antroseco/idp/Mechanical_DocumentationV2.pdf

# IDP - Mechanical documentation

## Team L212: The Seven Deadly Trins

## Trinity College

## Antros Economides 137 Jay Limachya 136 Jeevan Singh Bhoot 136 Valentina Njaradi 135 Nikodem Czarlinski 135 Omar Zaman 134 Jerry Shi 134

## 21 March 2021

# 1 Material Choice

## - 6mm thick MDF wood

## - PLA

## - 0.7mm thick sheet metal

# 2 Material Justification

## - Main goal was to create a simple and easy to manufacture robot

## - Wood used for the main body of the robot since it is easy to laser cut and put

## together

## - Comb joints are used here to increase the strength of the robot and are put together

## with wood glue. 6mm thick wood used to further increase the structural stability of the robot as it is the thickest material available

## - Sheet metal used for the brackets as it is easier to work with the bends

## - Use of PLA and 3D printing for parts which cannot be manufactured as easily with

## either wood or sheet metal

# 3 Manufacturing

## - Robot is laser cut via the dxf files (end of handout) on 6mm thick MDF wood and

## 0.7mm sheet metal

## - Wood glue used for the main body of the robot

## - Additional holes which need to be drilled are marked on the drawings

## - Sensors and other components are bolted to the robot in the positions shown in the drawings / renders

## - Holes in the 3D printed drawing are threaded

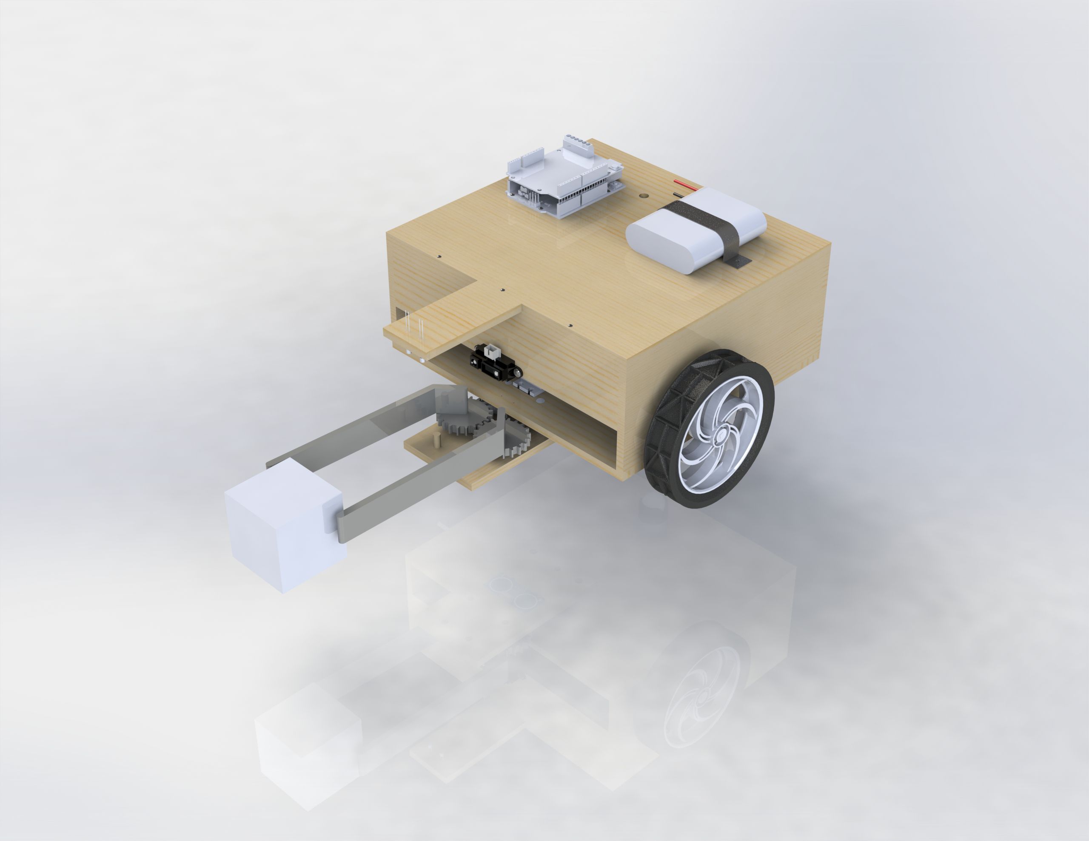
[picture p1: page 3]

5

4

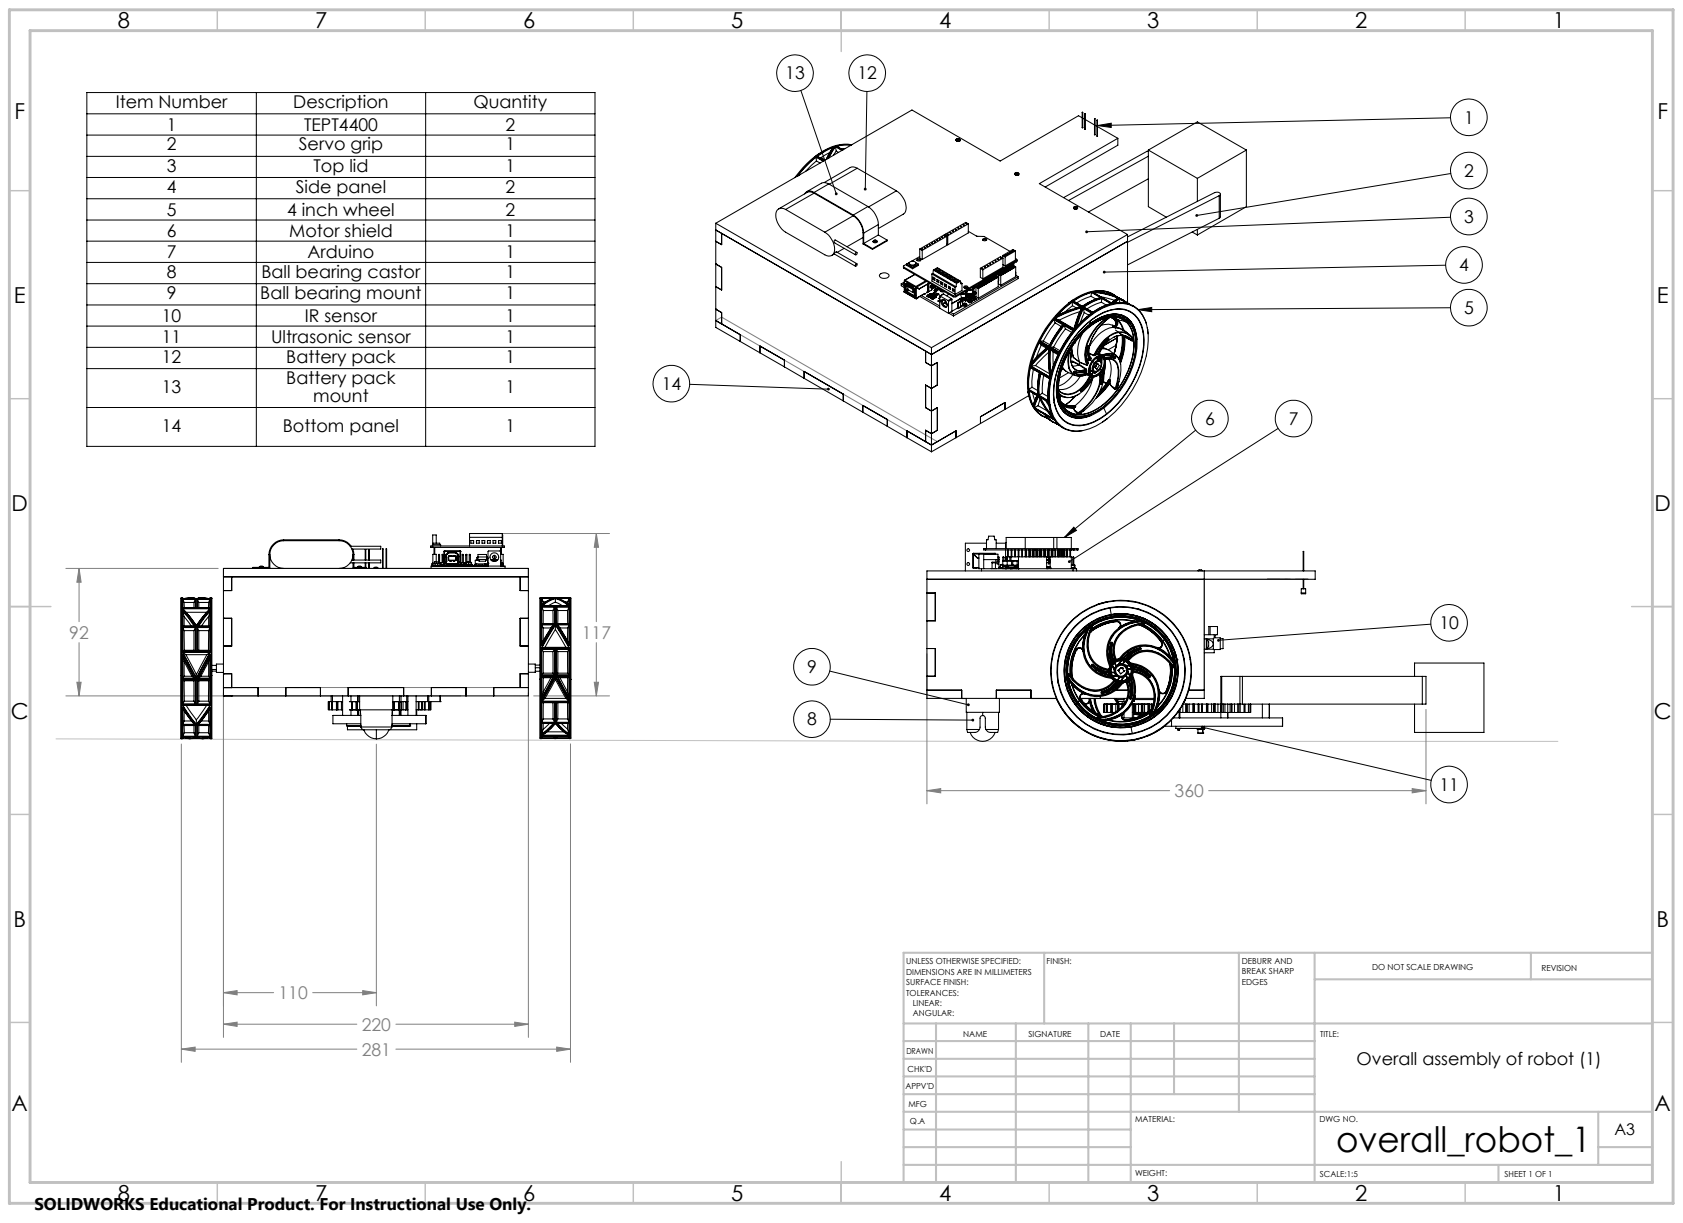
[picture p2: page 4]
FINISH:; DEBURR AND; BREAK SHARP EDGES; DO NOT SCALE DRAWING; REVISION; SCALE:1:5; SHEET 1 OF 1; WEIGHT:

Item Number | Description | Quantity
1 | TEPT4400 | 2
2 | Servo grip | 1
3 | Top lid | 1
4 | Side panel | 2
5 | 4 inch wheel | 2
6 | Motor shield | 1
7 | Arduino | 1
8 | Ball bearing castor | 1
9 | Ball bearing mount | 1
10 | IR sensor | 1
11 | Ultrasonic sensor | 1
12 | Battery pack | 1
13 | Battery pack mount | 1

14 | Bottom panel | 1

UNLESS OTHERWISE SPECIFIED:
DIMENSIONS ARE IN MILLIMETERS
SURFACE FINISH:
TOLERANCES:
LINEAR:
ANGULAR:

NAME | SIGNATURE | DATE | | | | TITLE: Overall assembly of robot (1)

DRAWN
CHK'D
APPV'D
MFG
Q.A | | | | MATERIAL: | DWG NO. overall_robot_1 | A3

SOLIDWORKS Educational Product. For Instructional Use Only.

E | E
F | F

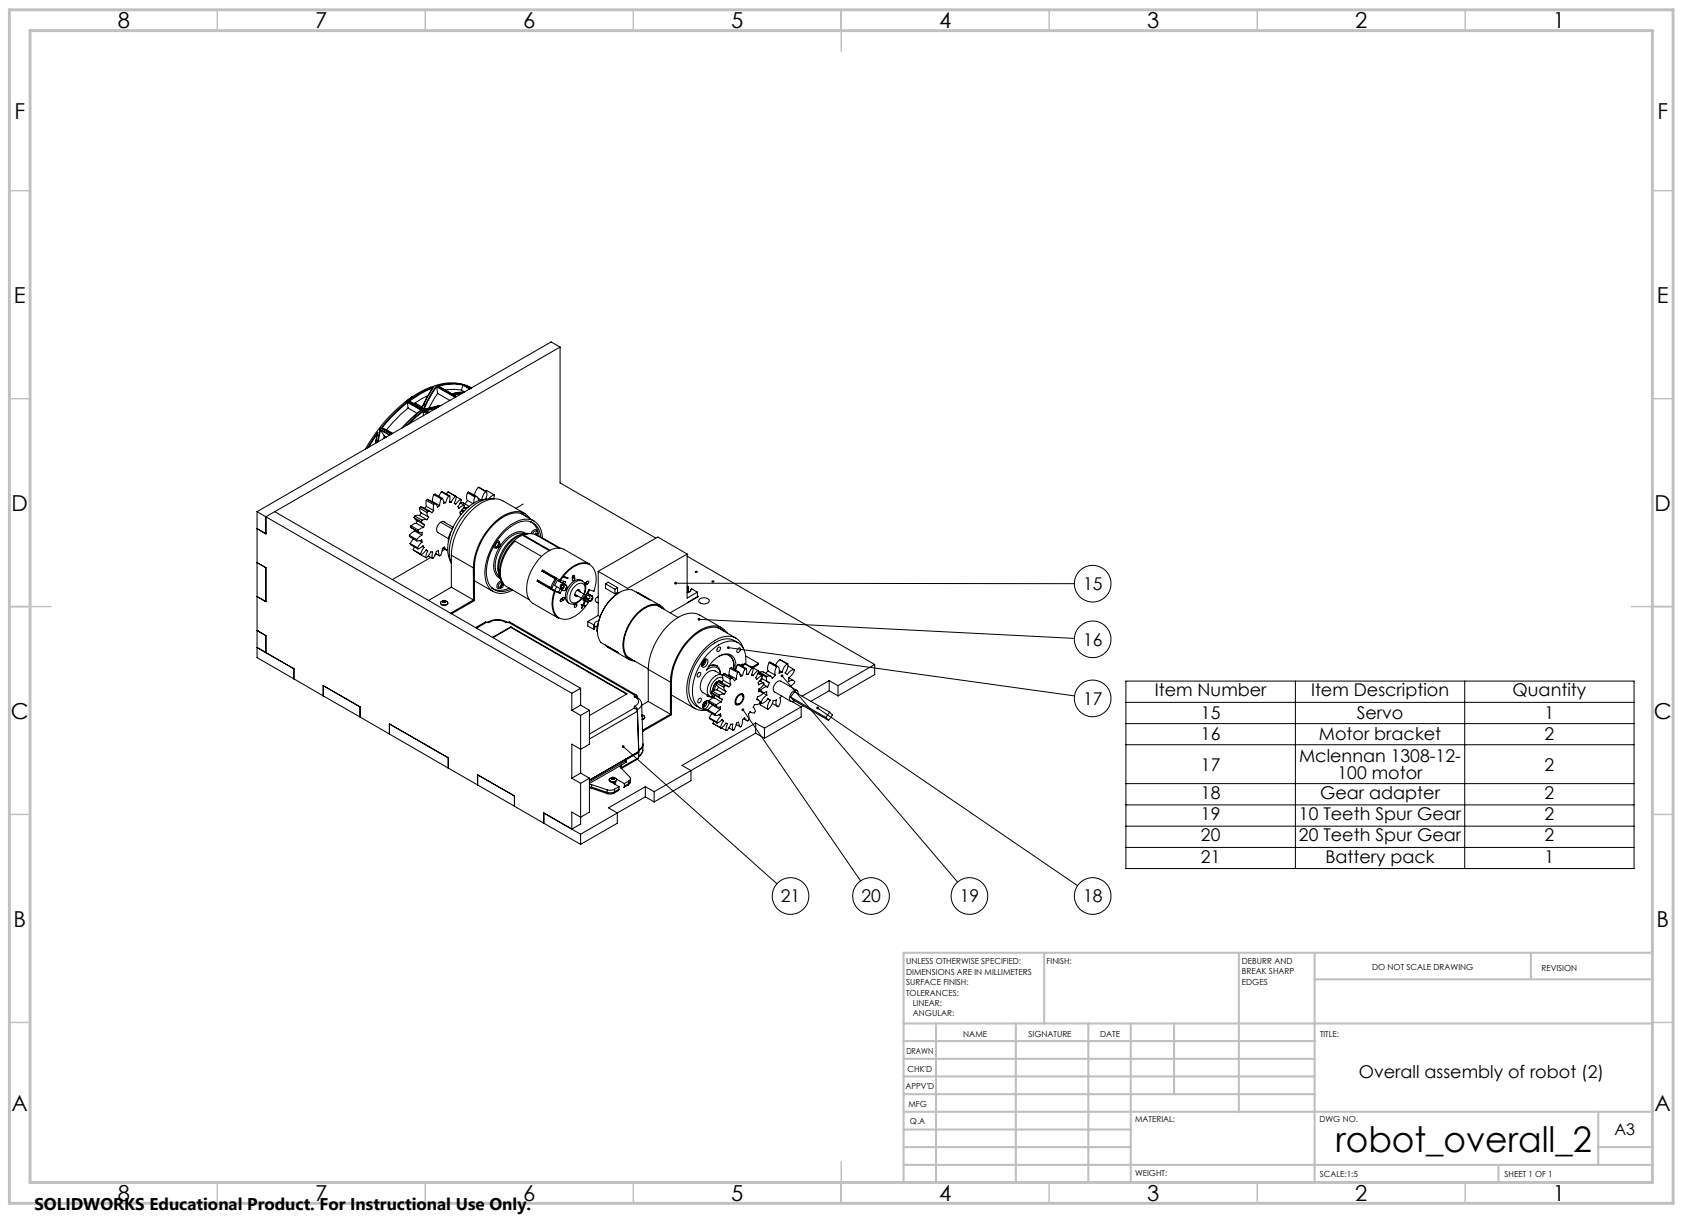
[picture p3: page 5]
FINISH:; DEBURR AND; BREAK SHARP EDGES; DO NOT SCALE DRAWING; REVISION

Item Number | Item Description | Quantity
15 | Servo | 1
16 | Motor bracket | 2
17 | Mclennan 1308-12-100 motor | 2
18 | Gear adapter | 2
19 | 10 Teeth Spur Gear | 2
20 | 20 Teeth Spur Gear | 2
21 | Battery pack | 1

UNLESS OTHERWISE SPECIFIED:
DIMENSIONS ARE IN MILLIMETERS
SURFACE FINISH:
TOLERANCES:
LINEAR:
ANGULAR:

NAME | SIGNATURE | DATE | | | TITLE: Overall assembly of robot (2)

DRAWN
CHK'D
APPV'D
MFG

robot_overall_2

SCALE:1:5 | SHEET 1 OF 1

E | E
F | F

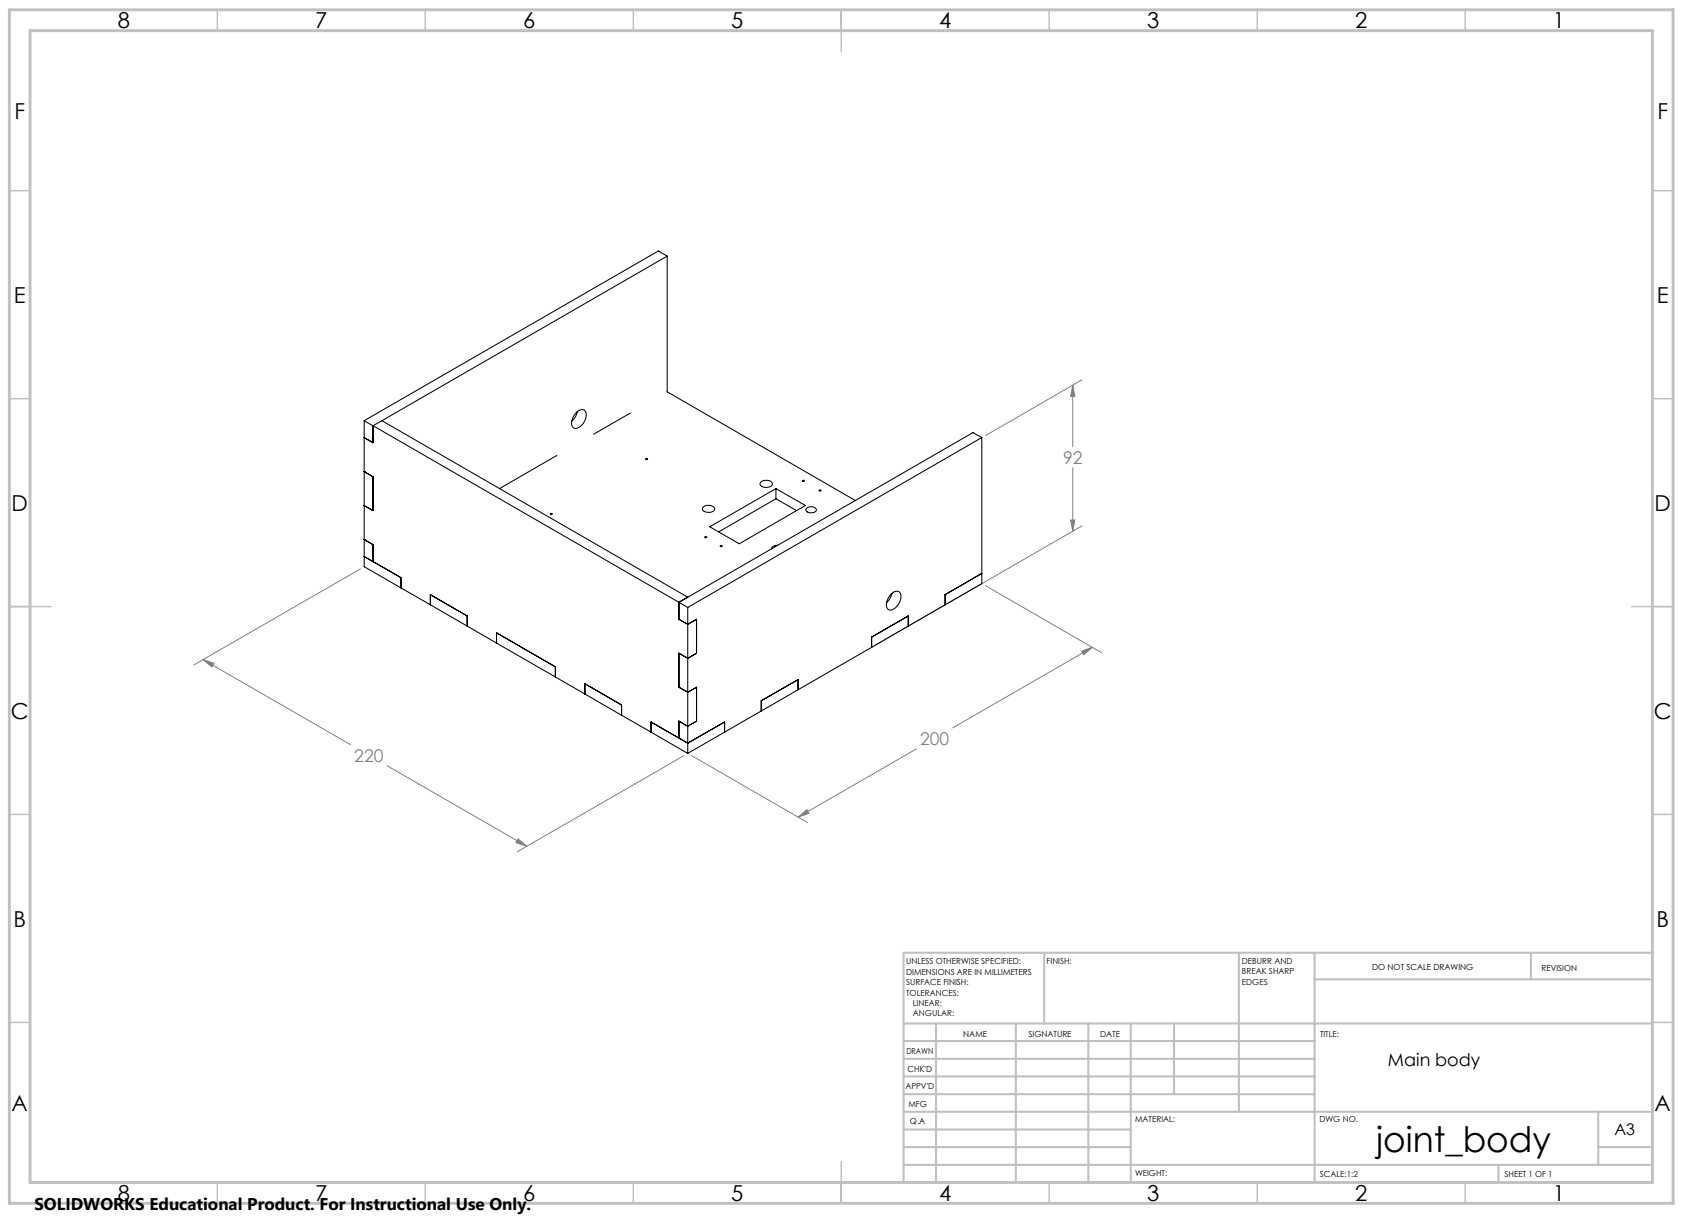
[picture p4: page 6]
FINISH:; DEBURR AND; BREAK SHARP EDGES; DO NOT SCALE DRAWING; REVISION

UNLESS OTHERWISE SPECIFIED:
DIMENSIONS ARE IN MILLIMETERS
SURFACE FINISH:
TOLERANCES:
LINEAR:
ANGULAR:

NAME | SIGNATURE | DATE | | | TITLE: Main body

DRAWN
CHK'D
APPV'D
MFG

joint_body

SCALE:1:2 | SHEET 1 OF 1

220

E | E

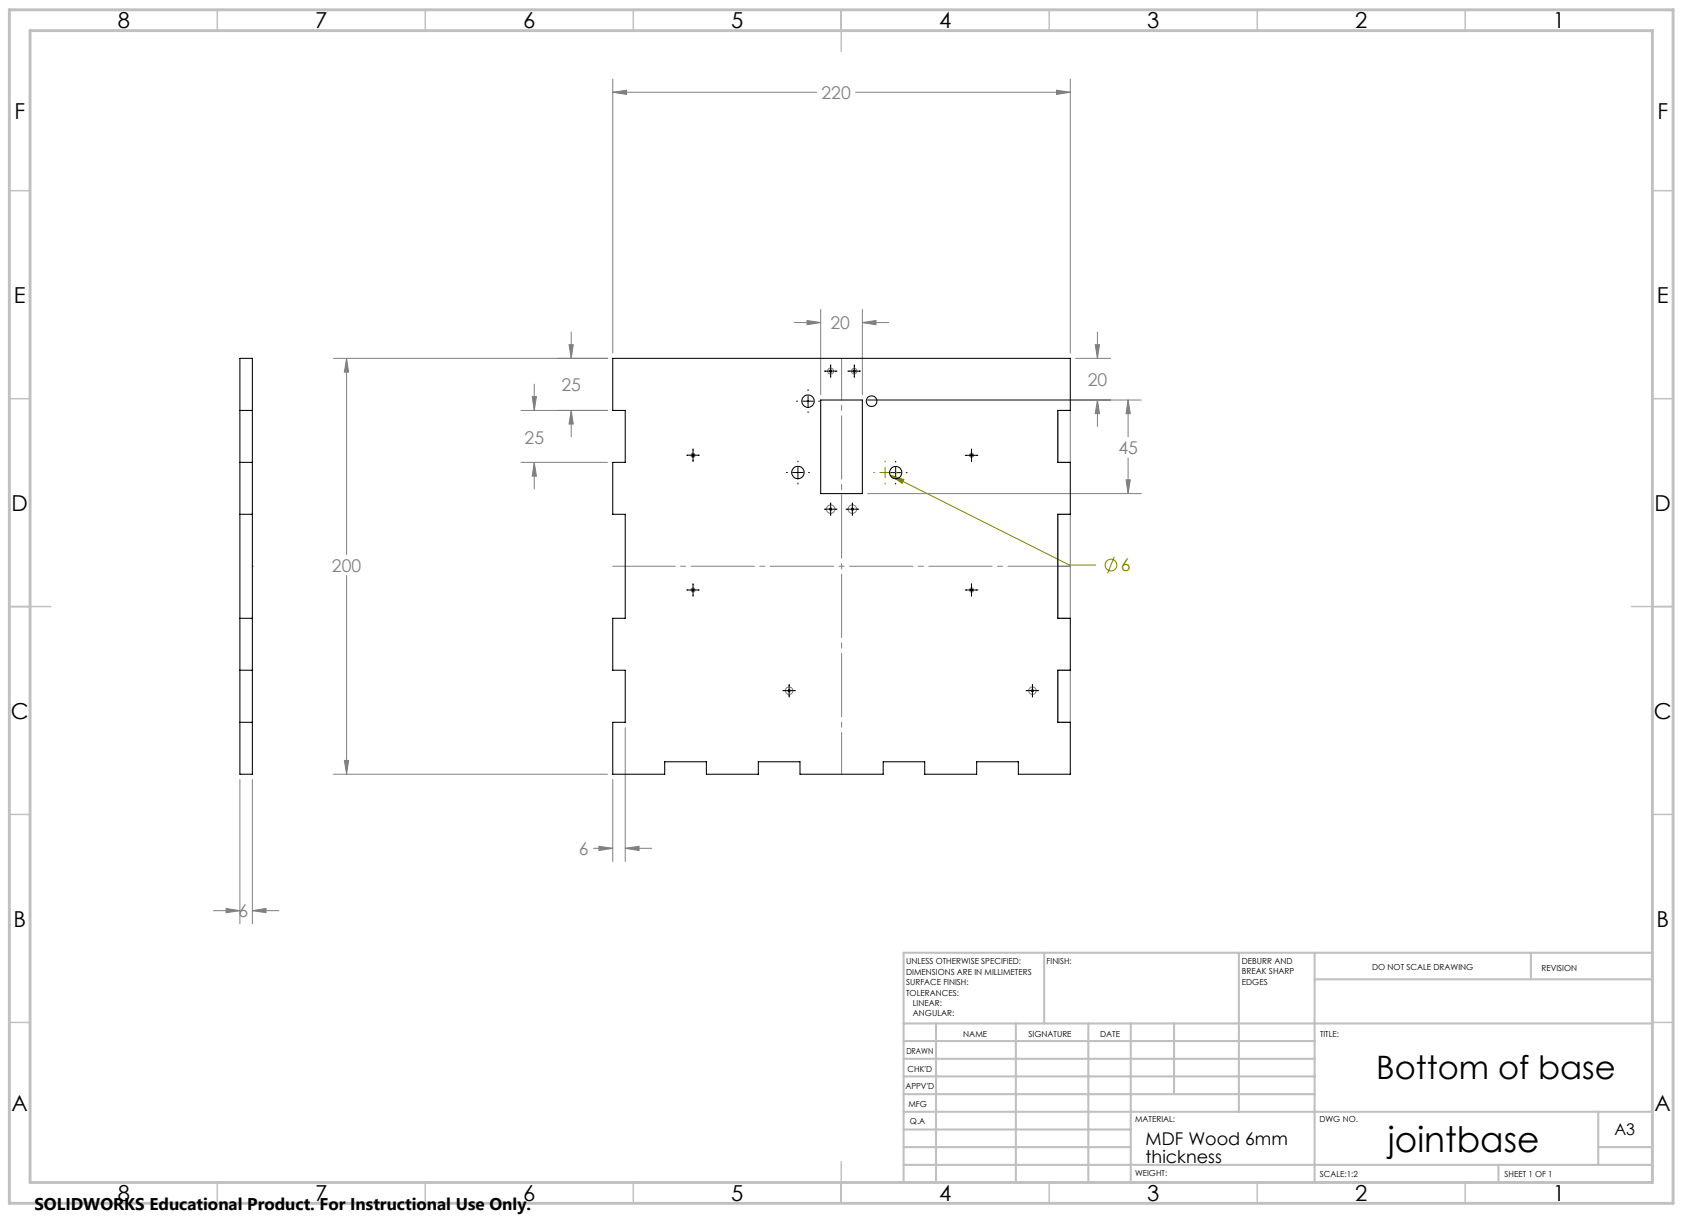
[picture p5: page 7]
FINISH:; DEBURR AND; BREAK SHARP EDGES; DO NOT SCALE DRAWING; REVISION

UNLESS OTHERWISE SPECIFIED:
DIMENSIONS ARE IN MILLIMETERS
SURFACE FINISH:
TOLERANCES:
LINEAR:
ANGULAR:

NAME | SIGNATURE | DATE | | | | TITLE: Bottom of base

DRAWN
CHK'D
APPV'D
MFG

MDF Wood 6mm thickness | jointbase

SCALE:1:2 | SHEET 1 OF 1

80

E | E

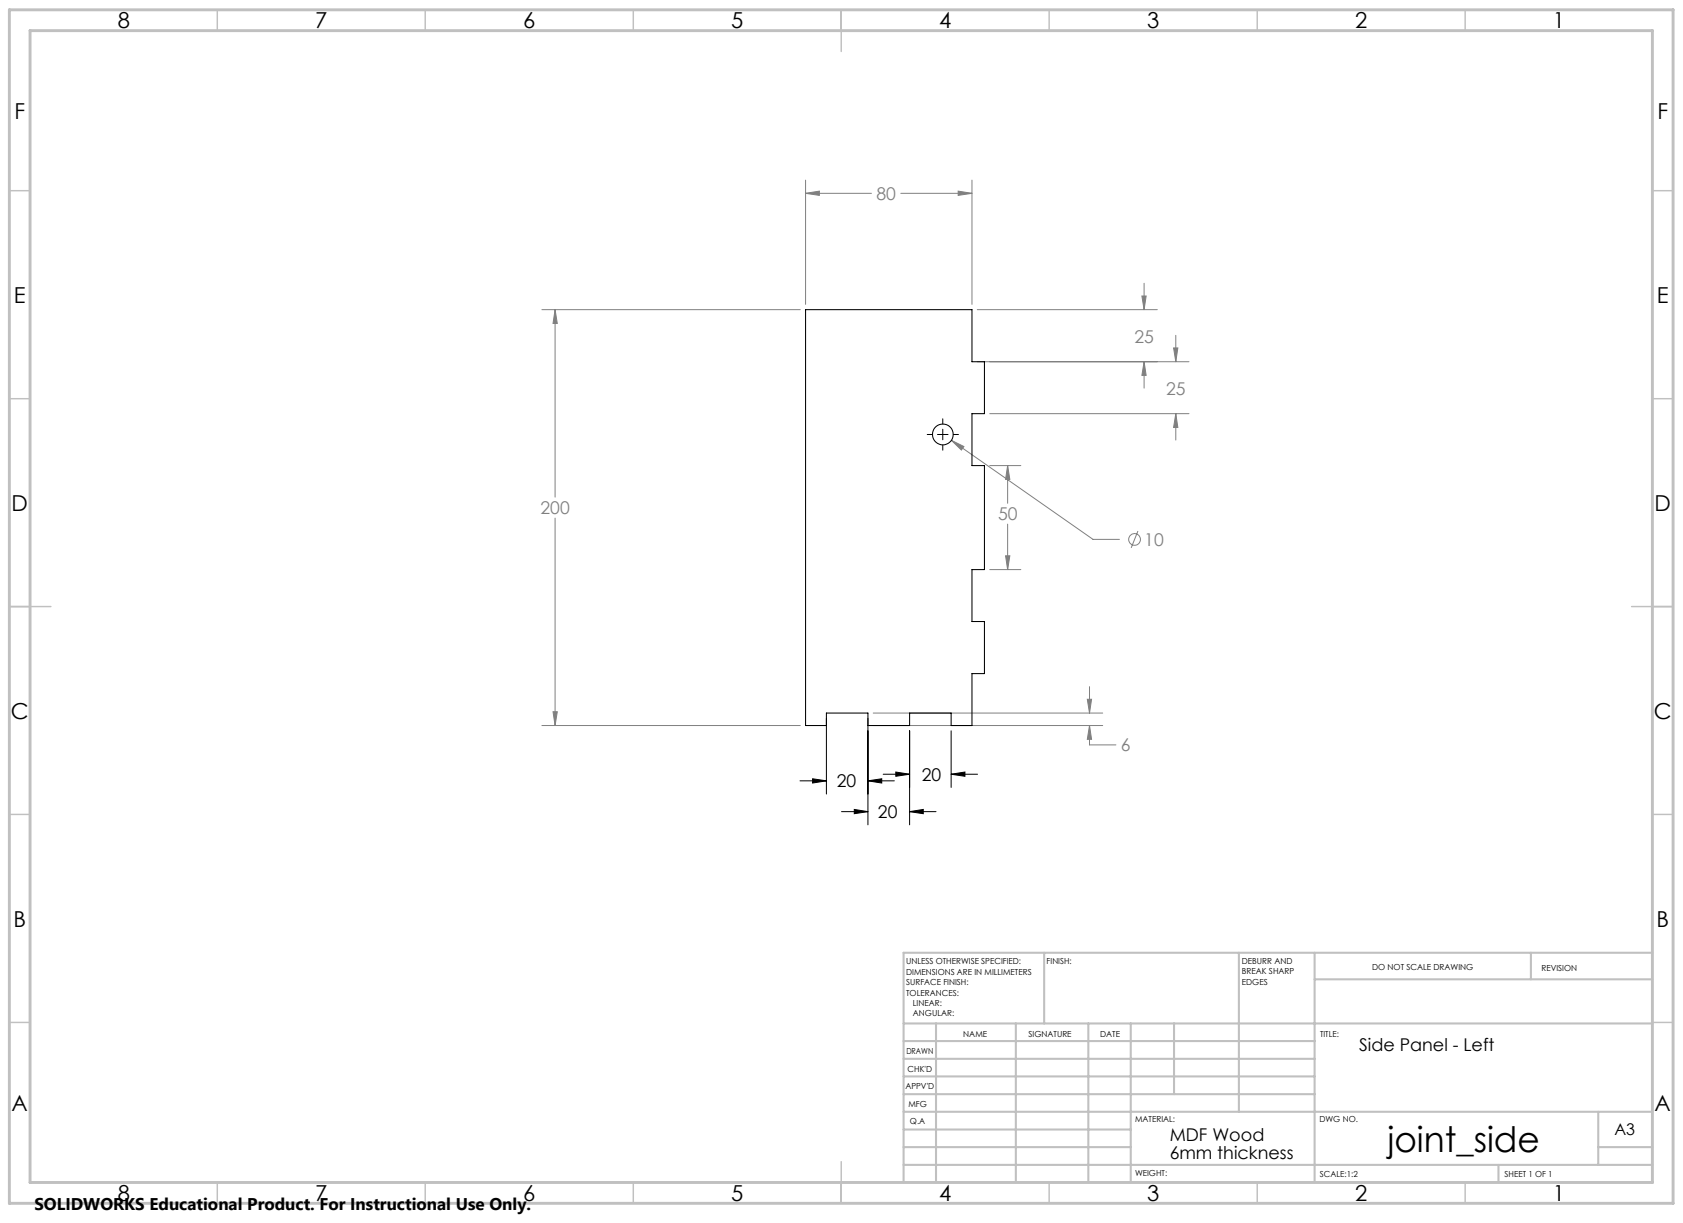
[picture p6: page 8]
FINISH:; DEBURR AND; BREAK SHARP EDGES; DO NOT SCALE DRAWING; REVISION

UNLESS OTHERWISE SPECIFIED:
DIMENSIONS ARE IN MILLIMETERS
SURFACE FINISH:
TOLERANCES:
LINEAR:
ANGULAR:

NAME | SIGNATURE | DATE | | | | TITLE: Side Panel - Left

DRAWN
CHK'D
APPV'D
MFG

MDF Wood 6mm thickness | joint_side

SCALE:1:2 | SHEET 1 OF 1

80

E | E

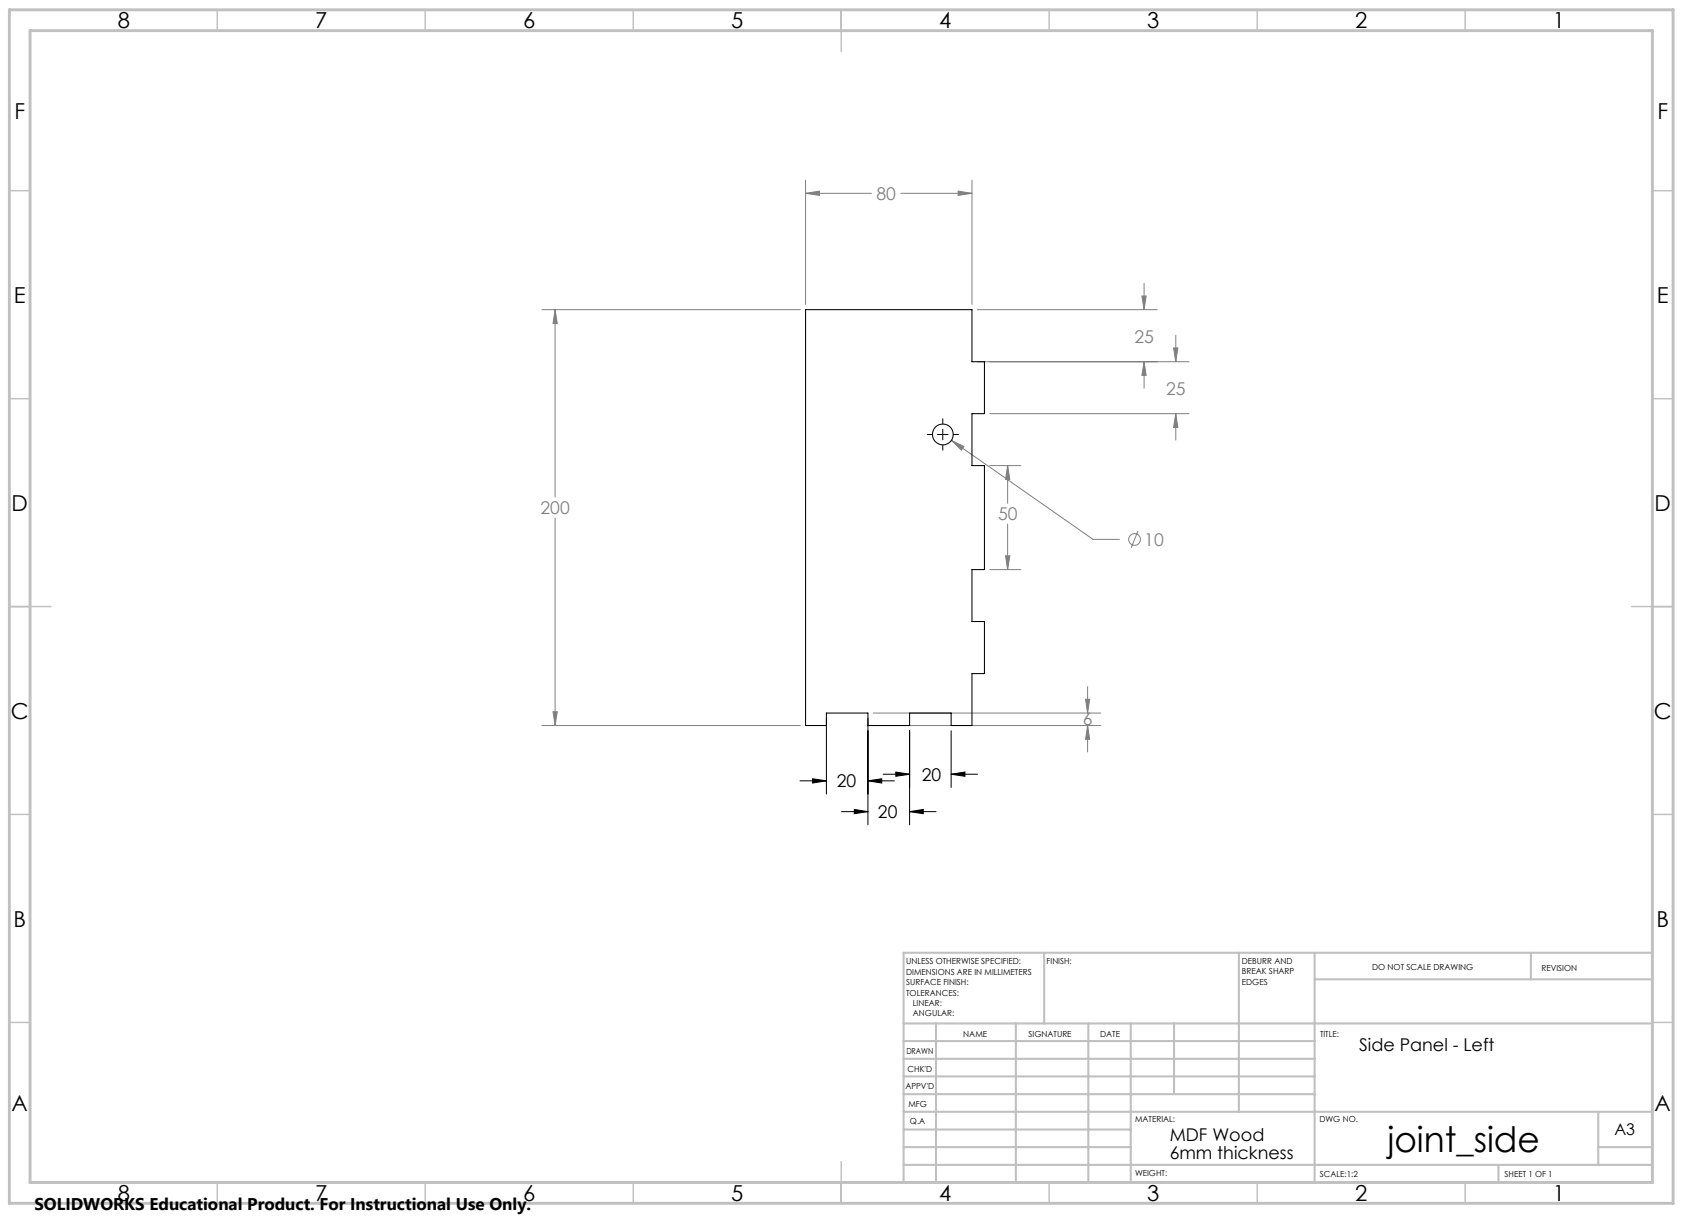
[picture p7: page 9]
FINISH:; DEBURR AND; BREAK SHARP EDGES; DO NOT SCALE DRAWING; REVISION

UNLESS OTHERWISE SPECIFIED:
DIMENSIONS ARE IN MILLIMETERS
SURFACE FINISH:
TOLERANCES:
LINEAR:
ANGULAR:

NAME | SIGNATURE | DATE | | | | TITLE: Side Panel - Left

DRAWN
CHK'D
APPV'D
MFG

MDF Wood 6mm thickness | joint_side

SCALE:1:2 | SHEET 1 OF 1

220
E | E

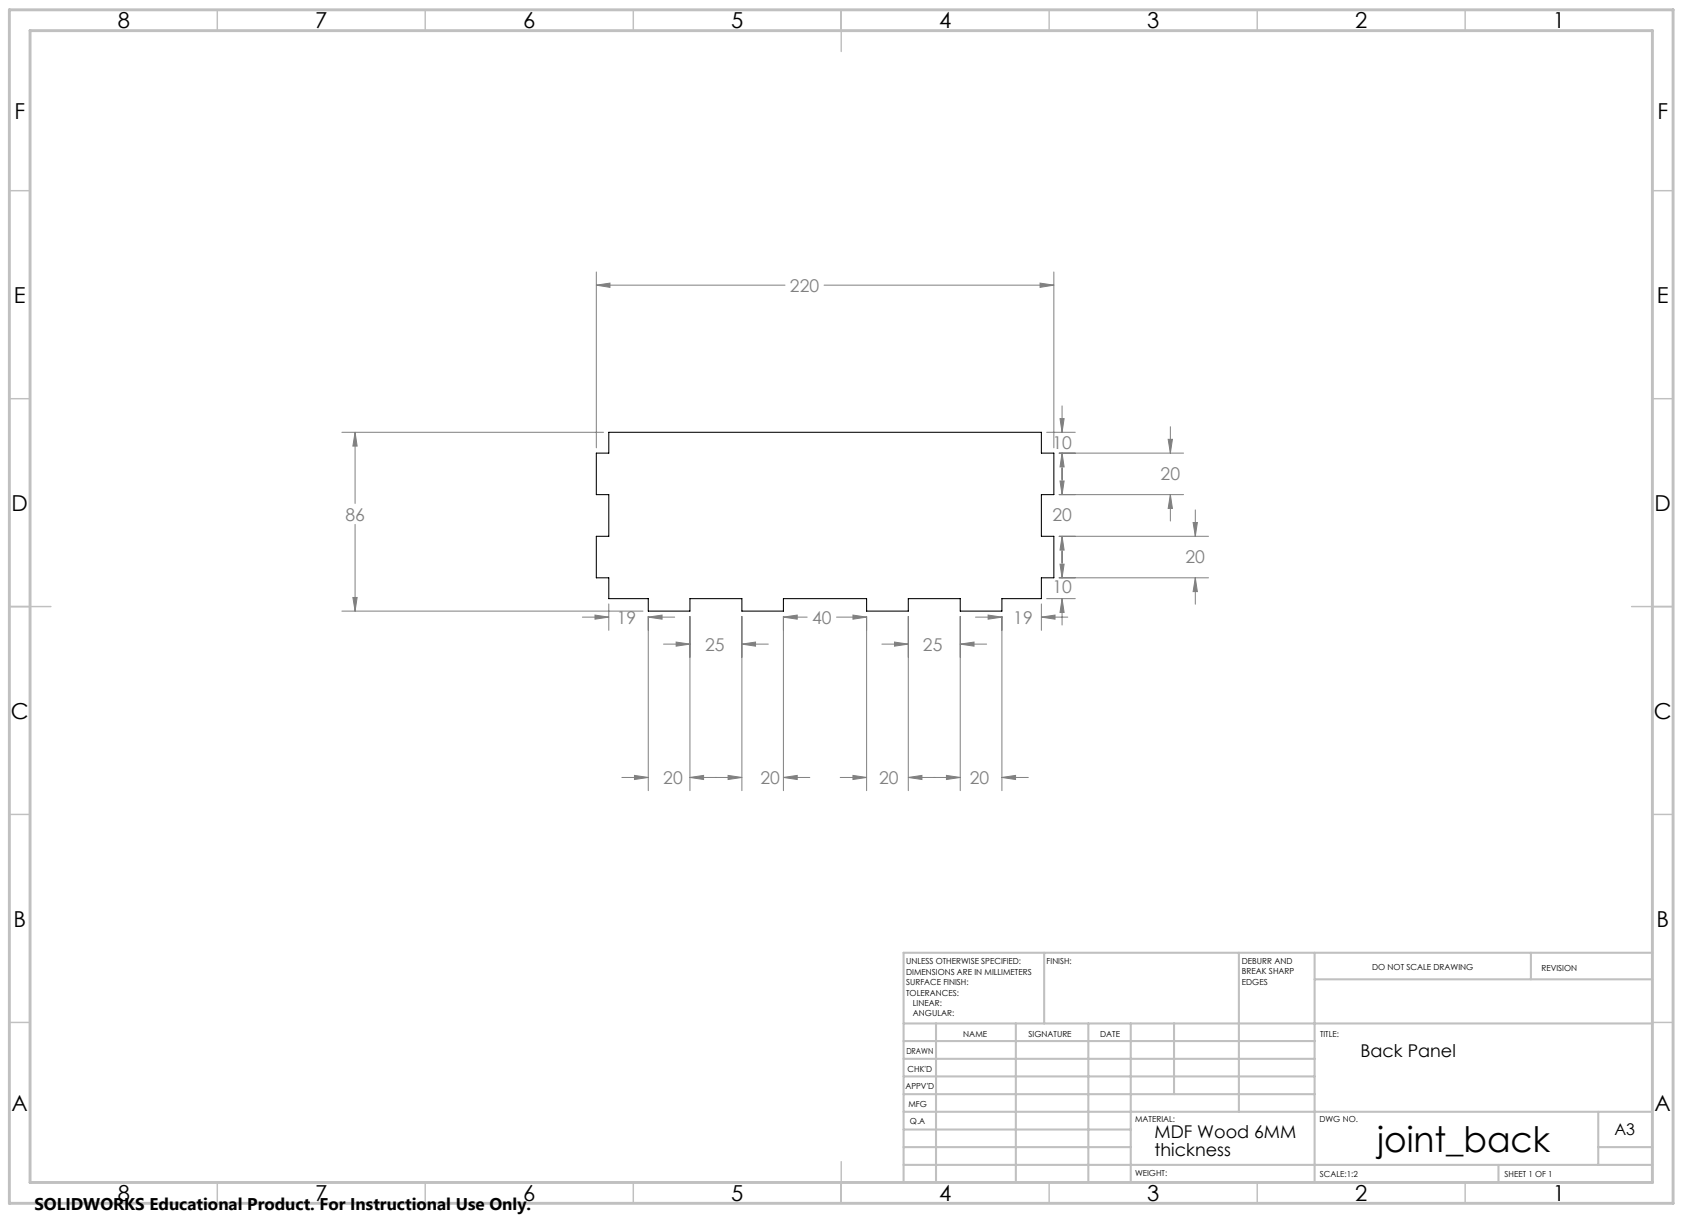
[picture p8: page 10]
FINISH:; DEBURR AND; BREAK SHARP EDGES; DO NOT SCALE DRAWING; REVISION

UNLESS OTHERWISE SPECIFIED:
DIMENSIONS ARE IN MILLIMETERS
SURFACE FINISH:
TOLERANCES:
LINEAR:
ANGULAR:

NAME | SIGNATURE | DATE | | | | TITLE: Back Panel

DRAWN
CHK'D
APPV'D
MFG

MDF Wood 6MM thickness | joint_back

SCALE:1:2 | SHEET 1 OF 1

220

TRUE R2 | TRUE R4

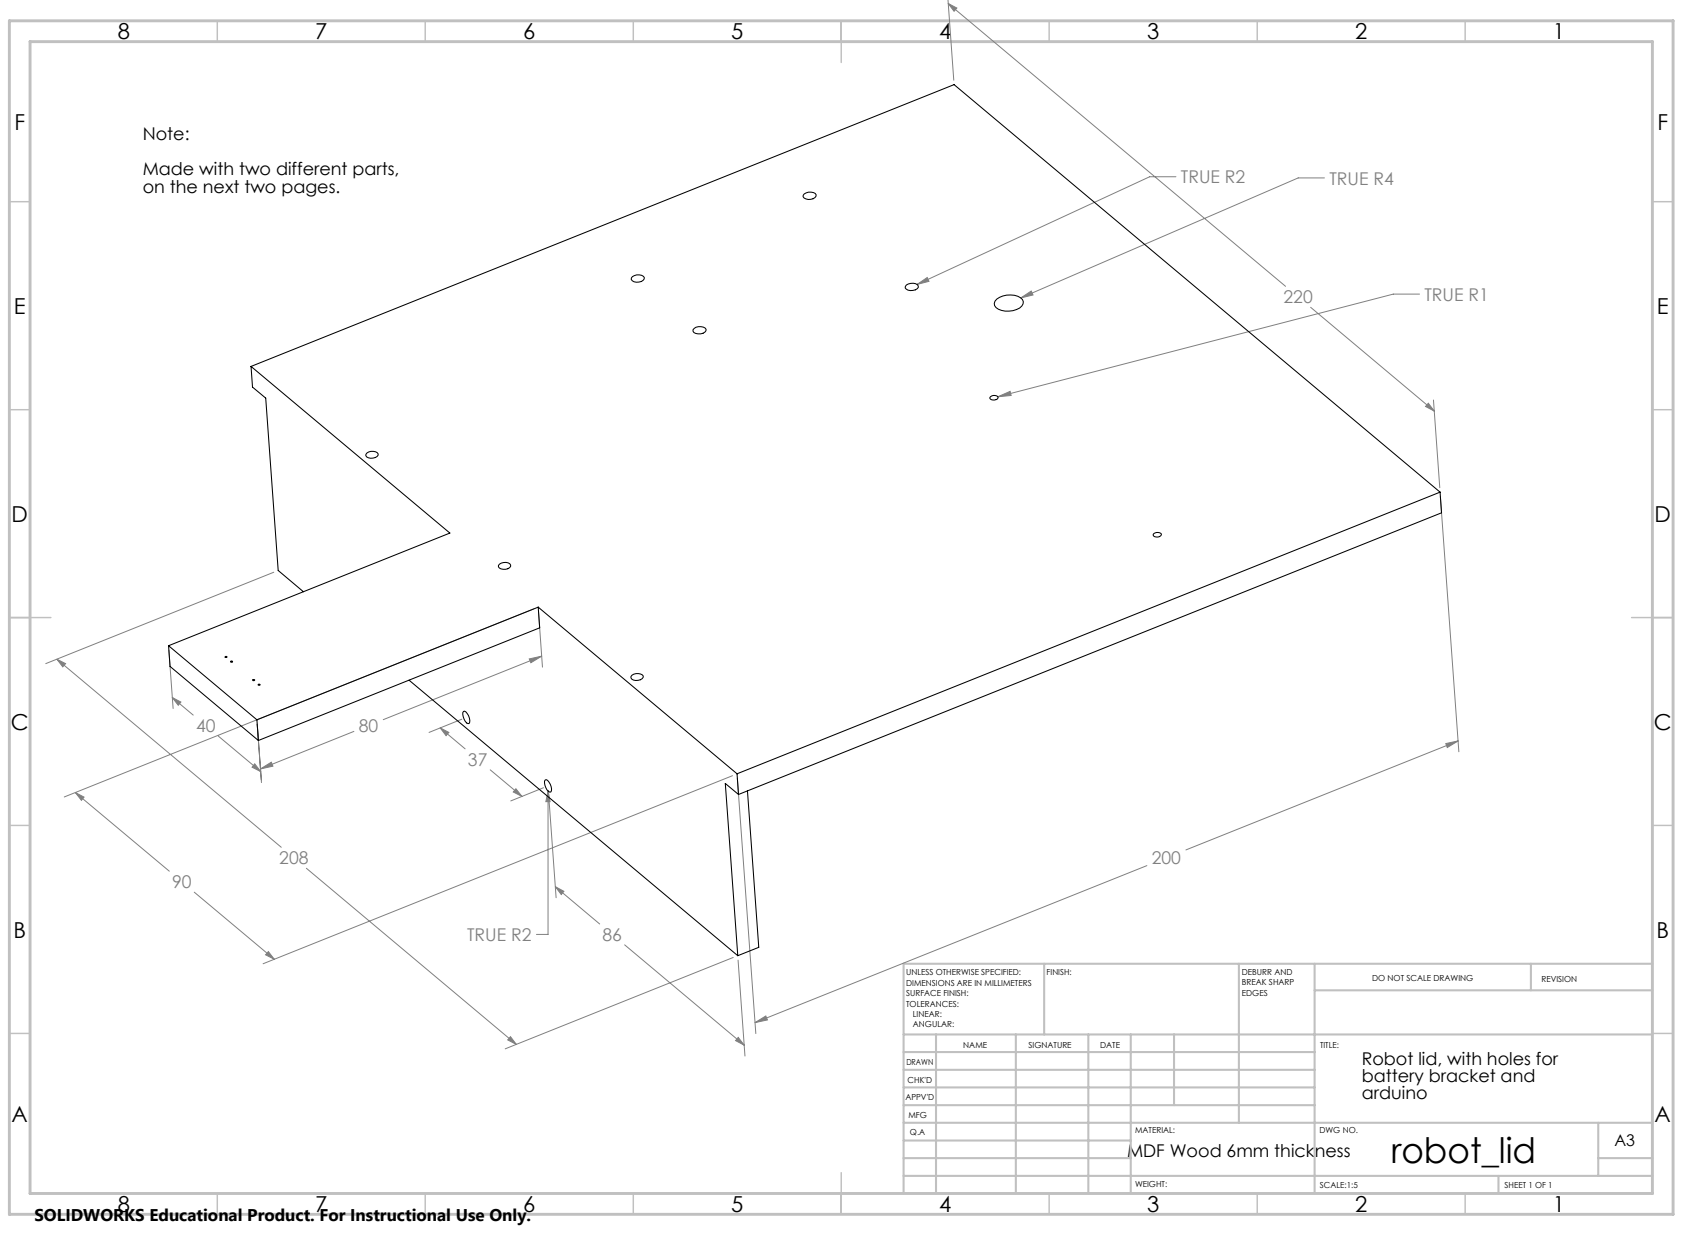
[picture p9: page 11]
TRUE R1; TRUE R2; FINISH:; DEBURR AND; BREAK SHARP EDGES; DO NOT SCALE DRAWING; REVISION

Note:
Made with two different parts,
on the next two pages.

UNLESS OTHERWISE SPECIFIED:
DIMENSIONS ARE IN MILLIMETERS
SURFACE FINISH:
TOLERANCES:
LINEAR:
ANGULAR:

NAME | SIGNATURE | DATE | | | TITLE: Robot lid, with holes for battery bracket and arduino

DRAWN
CHK'D
APPV'D
MFG

MDF Wood 6mm thickness | robot_lid

SCALE:1:5 | SHEET 1 OF 1

E | E
F | F

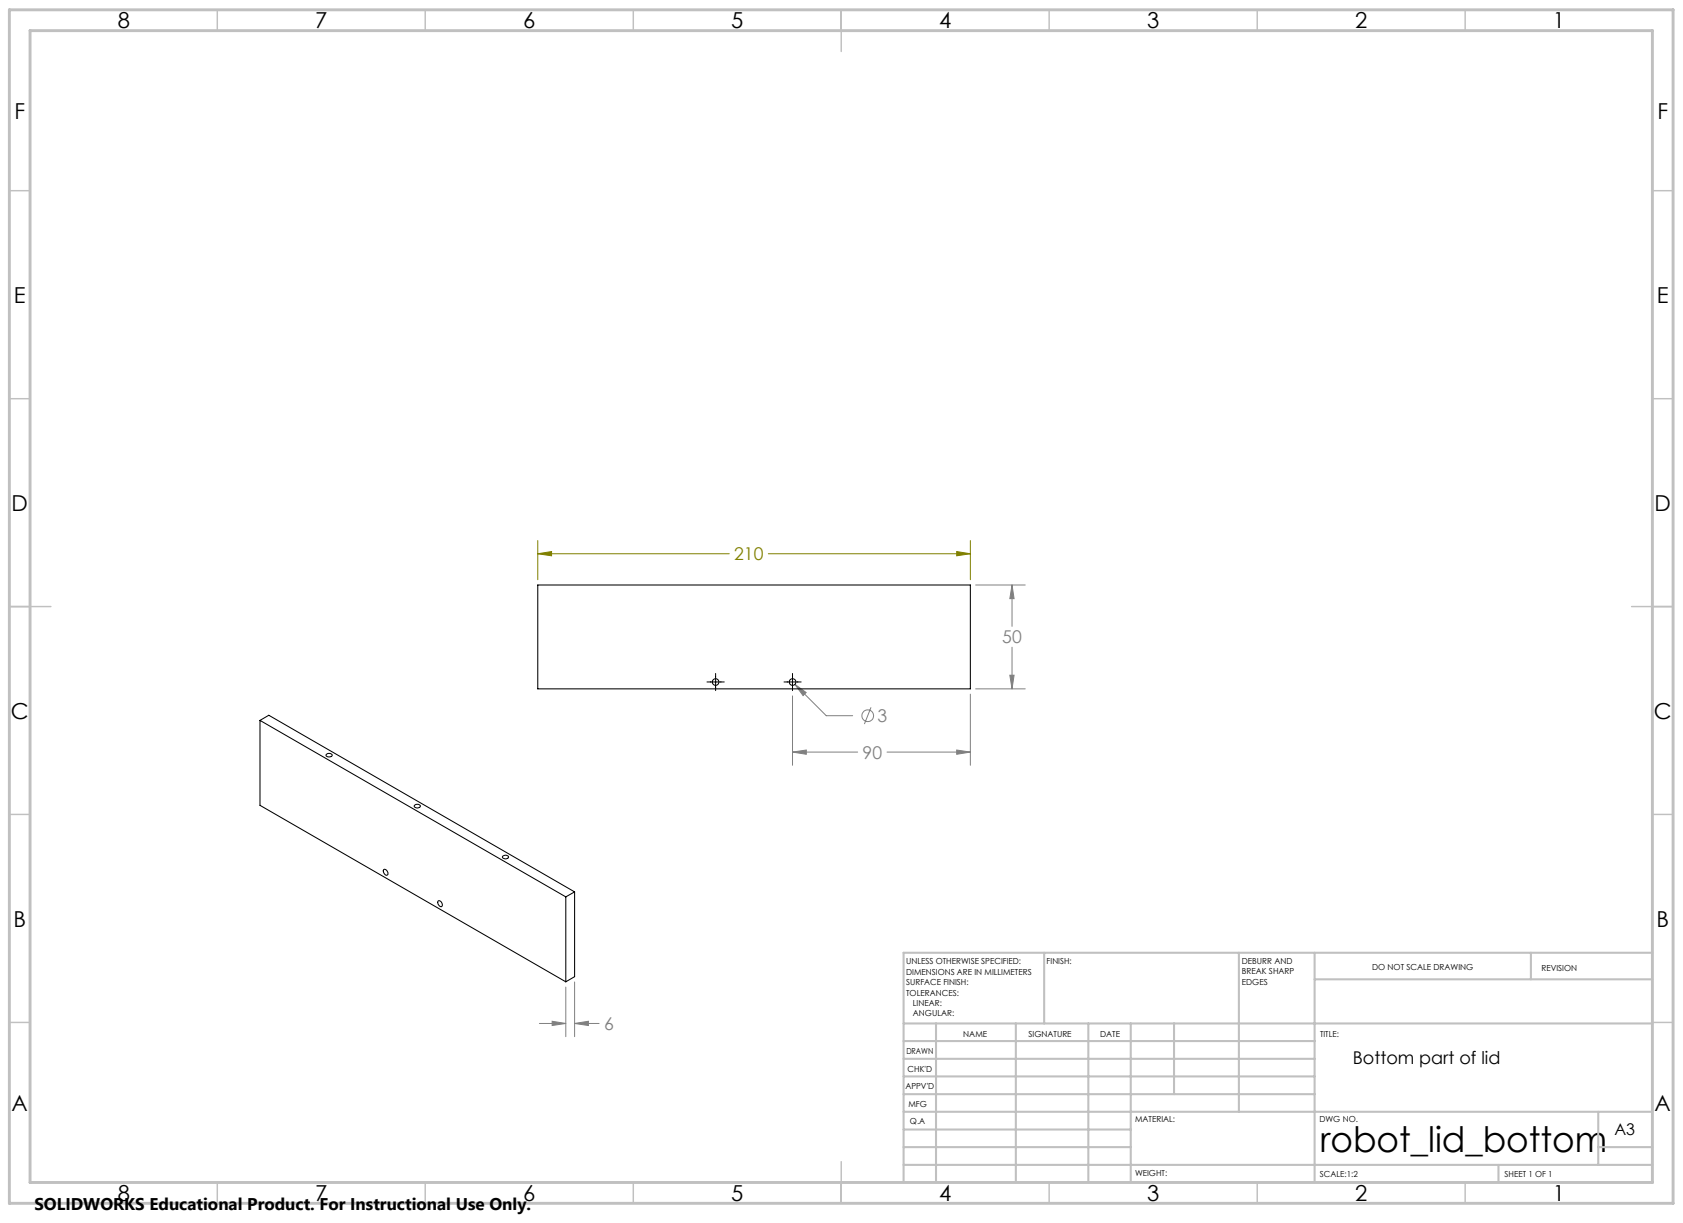
[picture p10: page 12]
FINISH:; DEBURR AND; BREAK SHARP EDGES; DO NOT SCALE DRAWING; REVISION

UNLESS OTHERWISE SPECIFIED:
DIMENSIONS ARE IN MILLIMETERS
SURFACE FINISH:
TOLERANCES:
LINEAR:
ANGULAR:

NAME | SIGNATURE | DATE | | | TITLE: Bottom part of lid

DRAWN
CHK'D
APPV'D
MFG

robot_lid_bottom

SCALE:1:2 | SHEET 1 OF 1

E | E
F | F

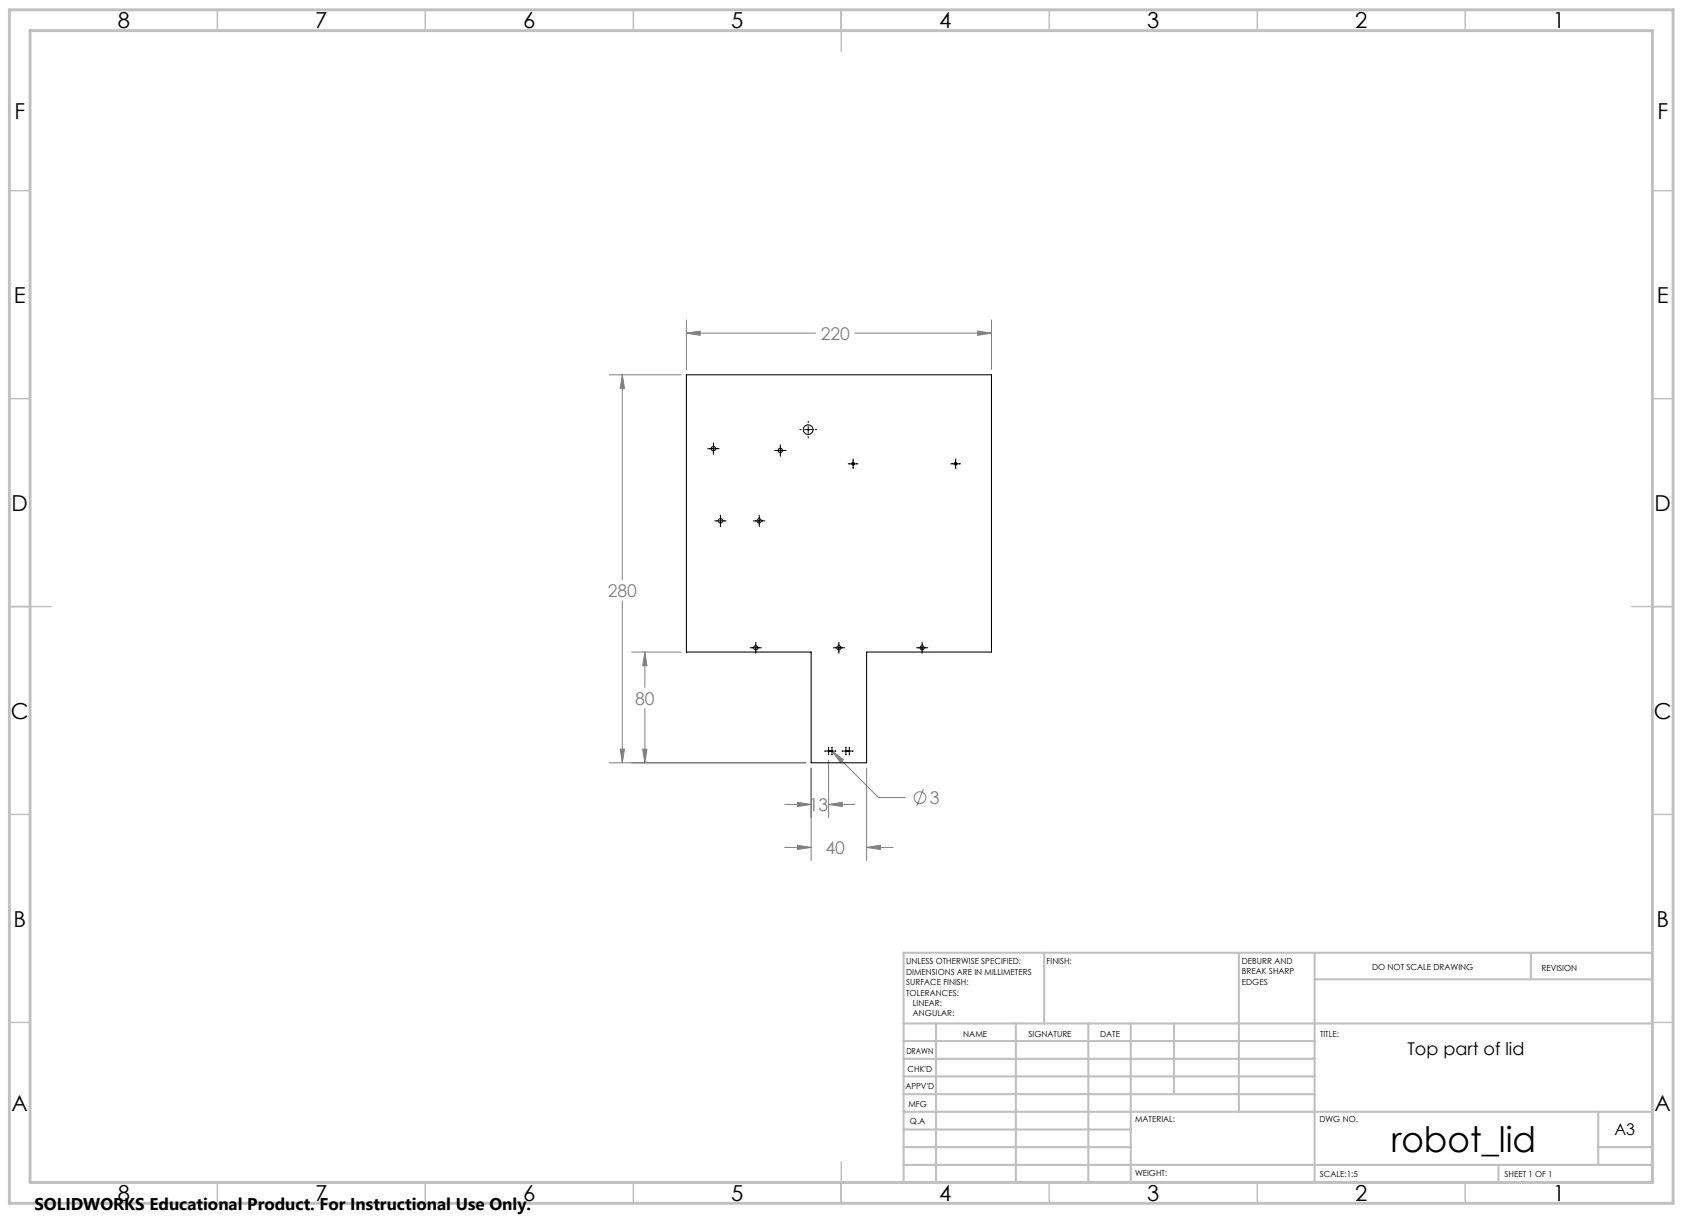
[picture p11: page 13]
FINISH:; DEBURR AND; BREAK SHARP EDGES; DO NOT SCALE DRAWING; REVISION

UNLESS OTHERWISE SPECIFIED:
DIMENSIONS ARE IN MILLIMETERS
SURFACE FINISH:
TOLERANCES:
LINEAR:
ANGULAR:

NAME | SIGNATURE | DATE | | | TITLE: Top part of lid

DRAWN
CHK'D
APPV'D
MFG

robot_lid

SCALE:1:5 | SHEET 1 OF 1

3.20

32.86

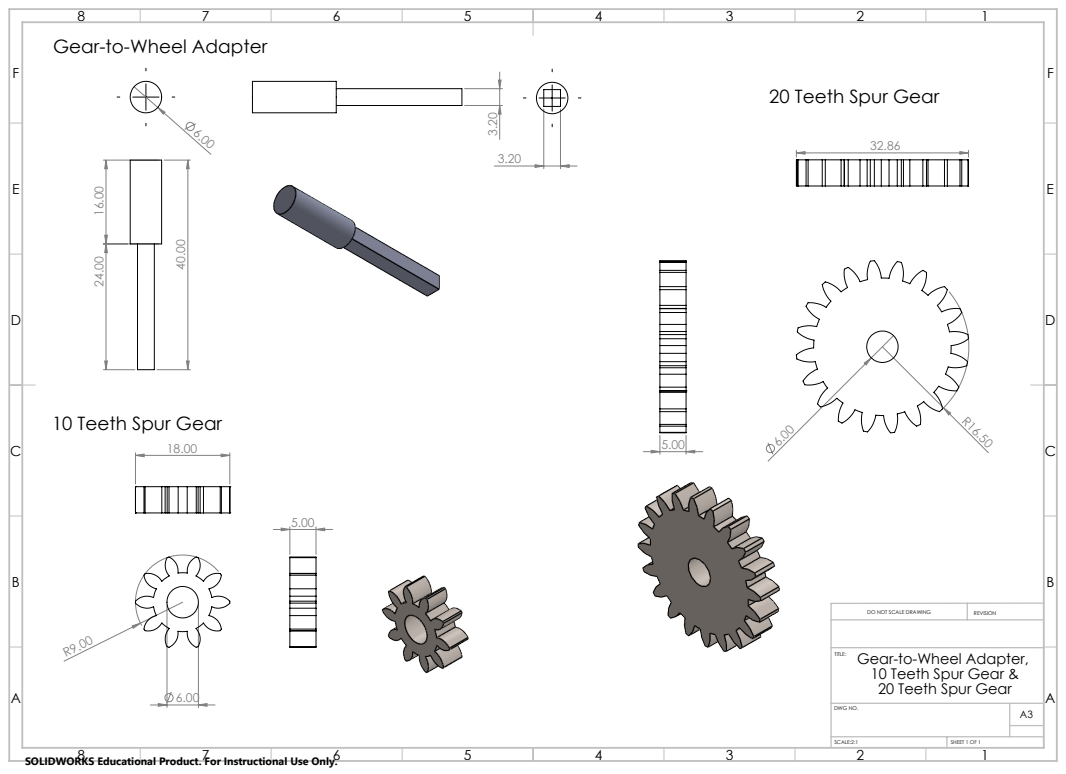
[picture p12: page 14]
DO NOT SCALE DRAWING; REVISION; TITLE:; SCALE:2:1; SHEET 1 OF 1

Gear-to-Wheel Adapter

20 Teeth Spur Gear

10 Teeth Spur Gear

Gear-to-Wheel Adapter,
10 Teeth Spur Gear &

E | E
F | F

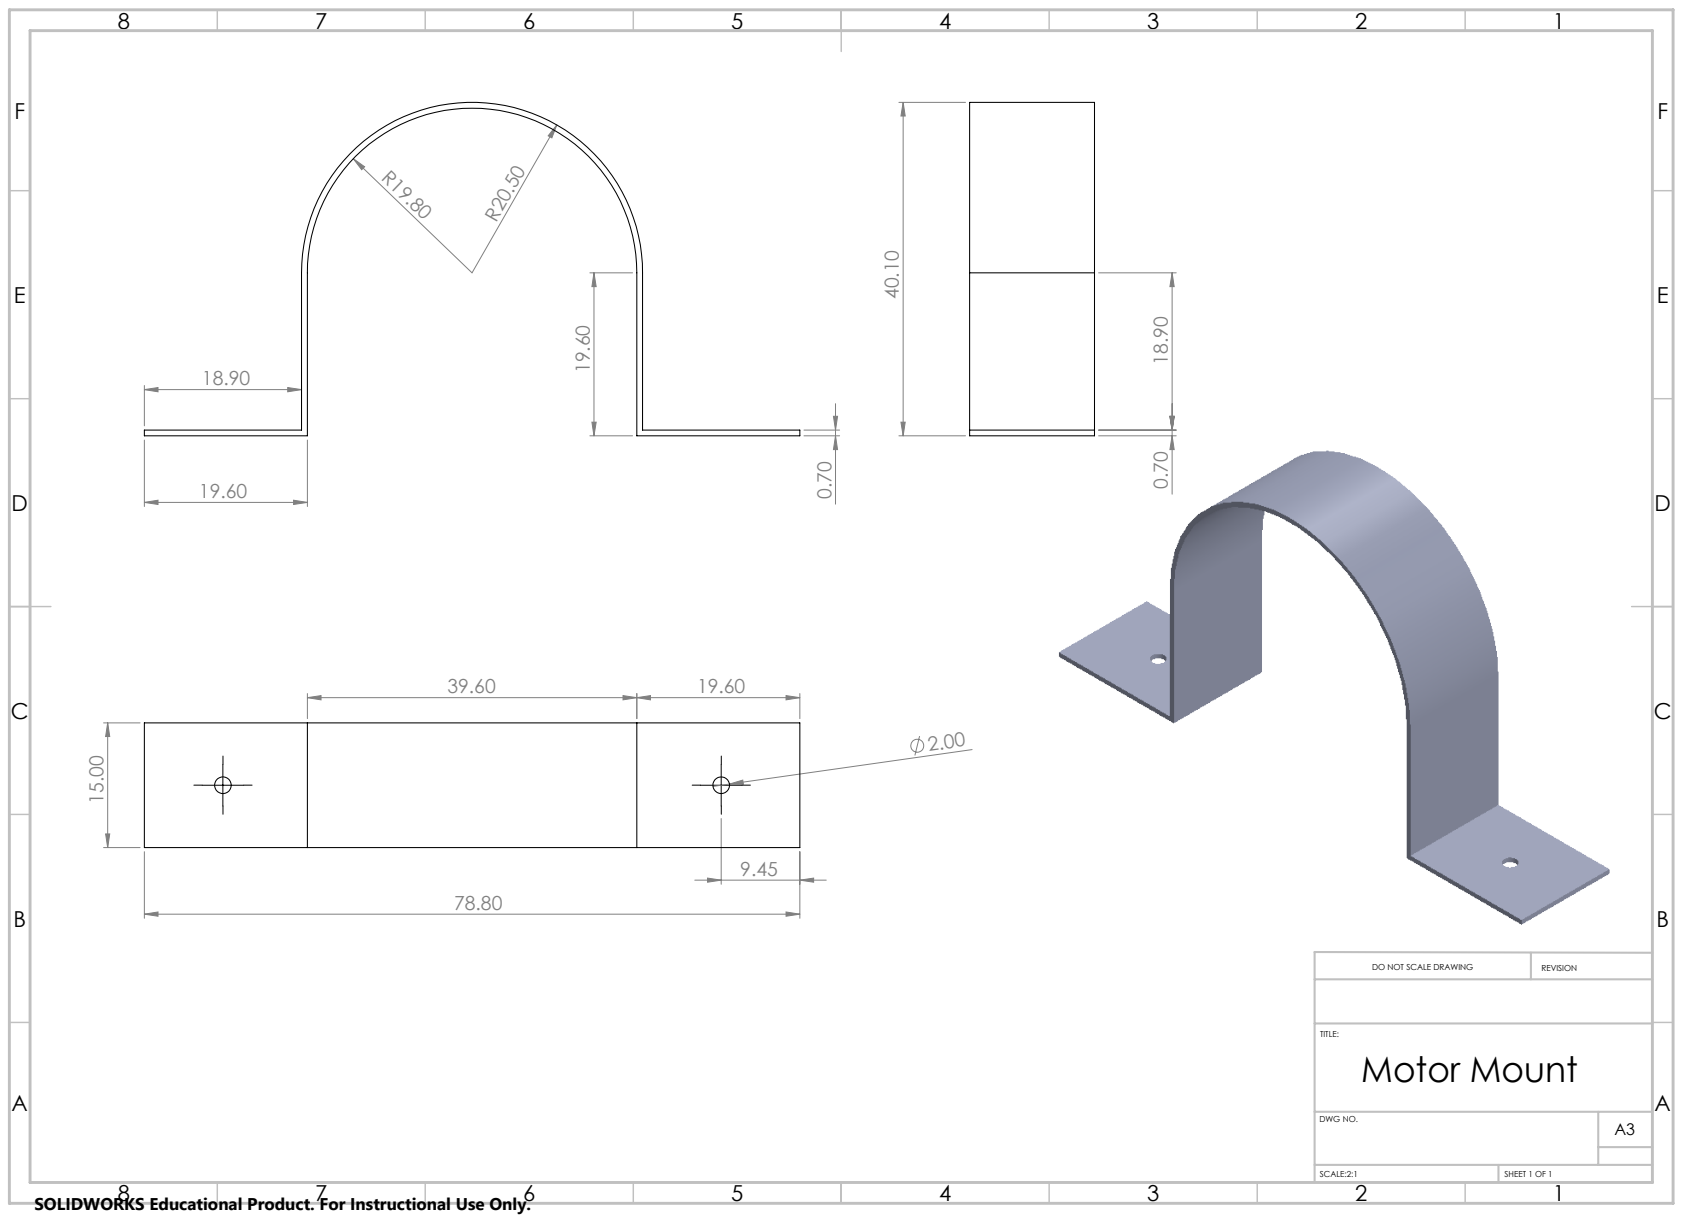
[picture p13: page 15]
DO NOT SCALE DRAWING; REVISION; TITLE:; SCALE:2:1; SHEET 1 OF 1; Motor Mount

140.17

19.77 | 50.32 | 9.45

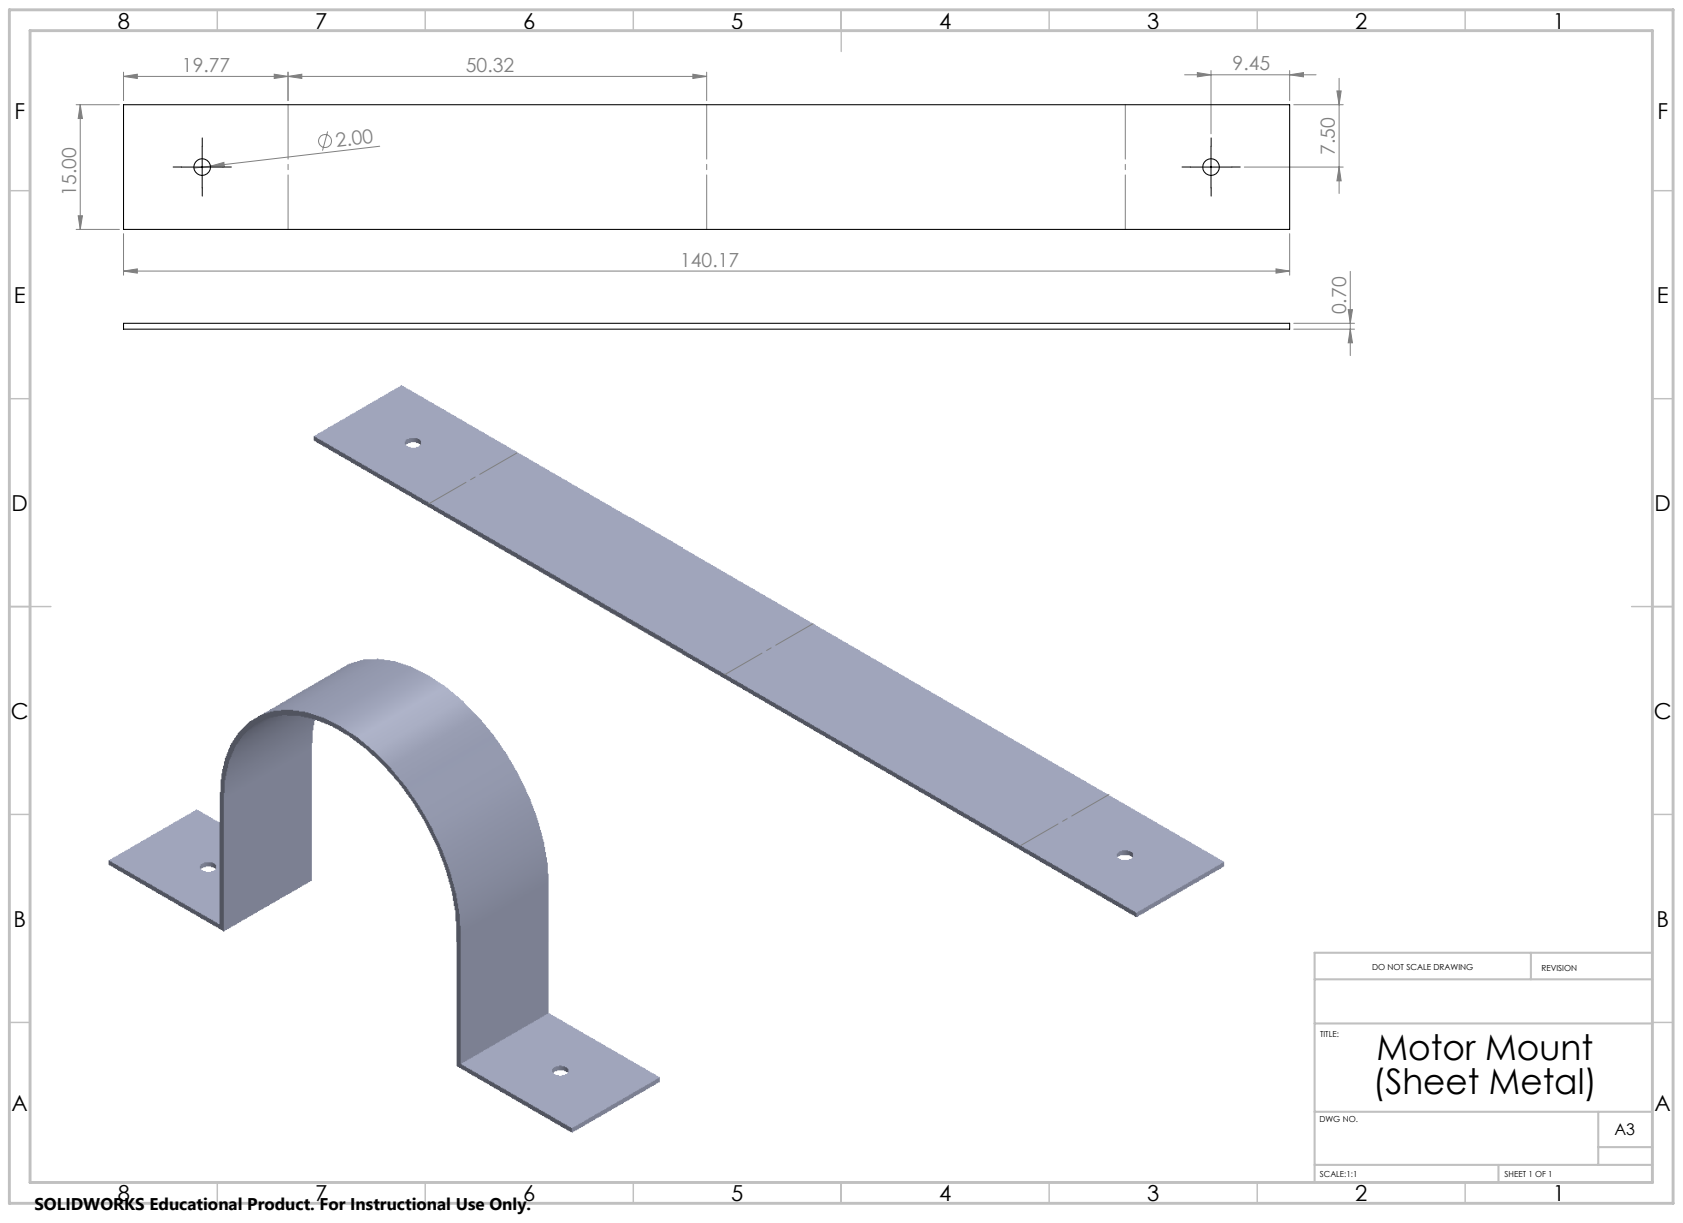
[picture p14: page 16]
DO NOT SCALE DRAWING; REVISION; TITLE:; SCALE:1:1; SHEET 1 OF 1; Motor Mount (Sheet Metal)

140.17

19.77 | 50.32 | 9.45

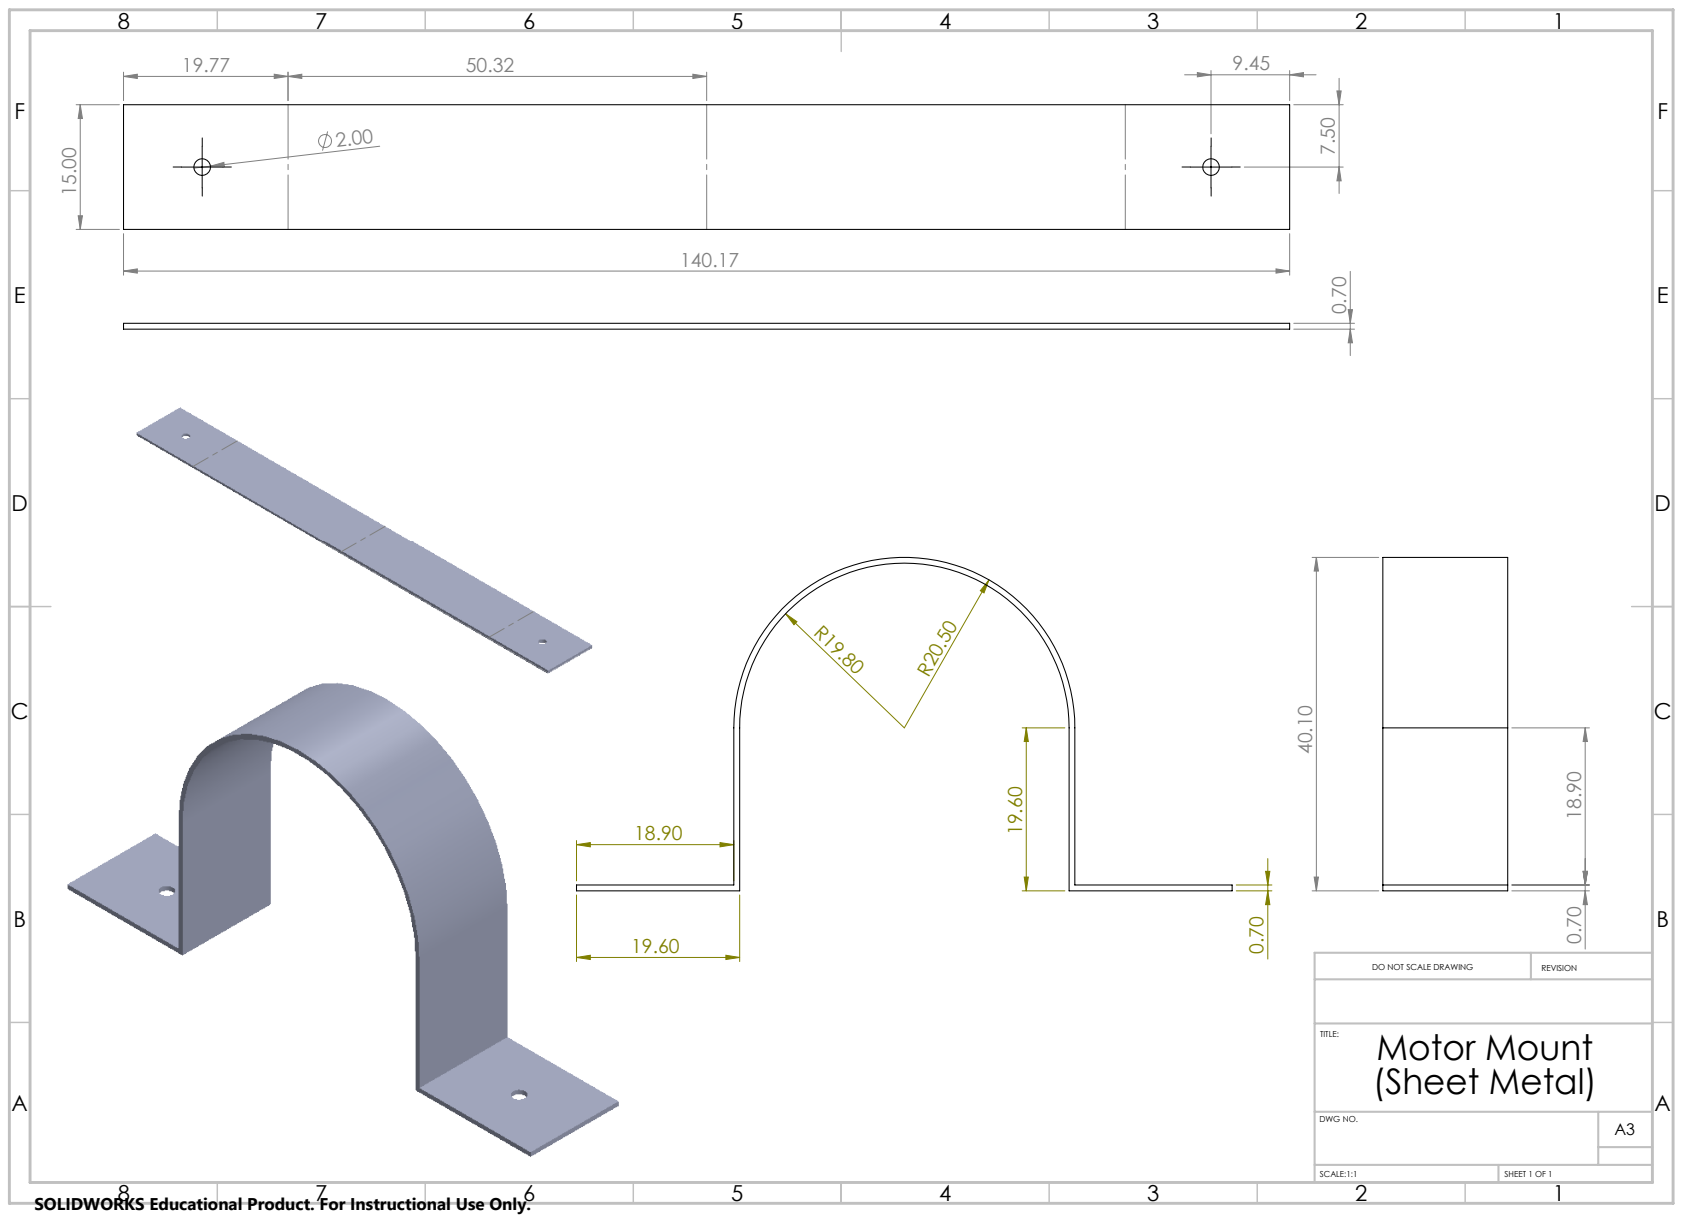
[picture p15: page 17]
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

1 | 2 | 3
E | E

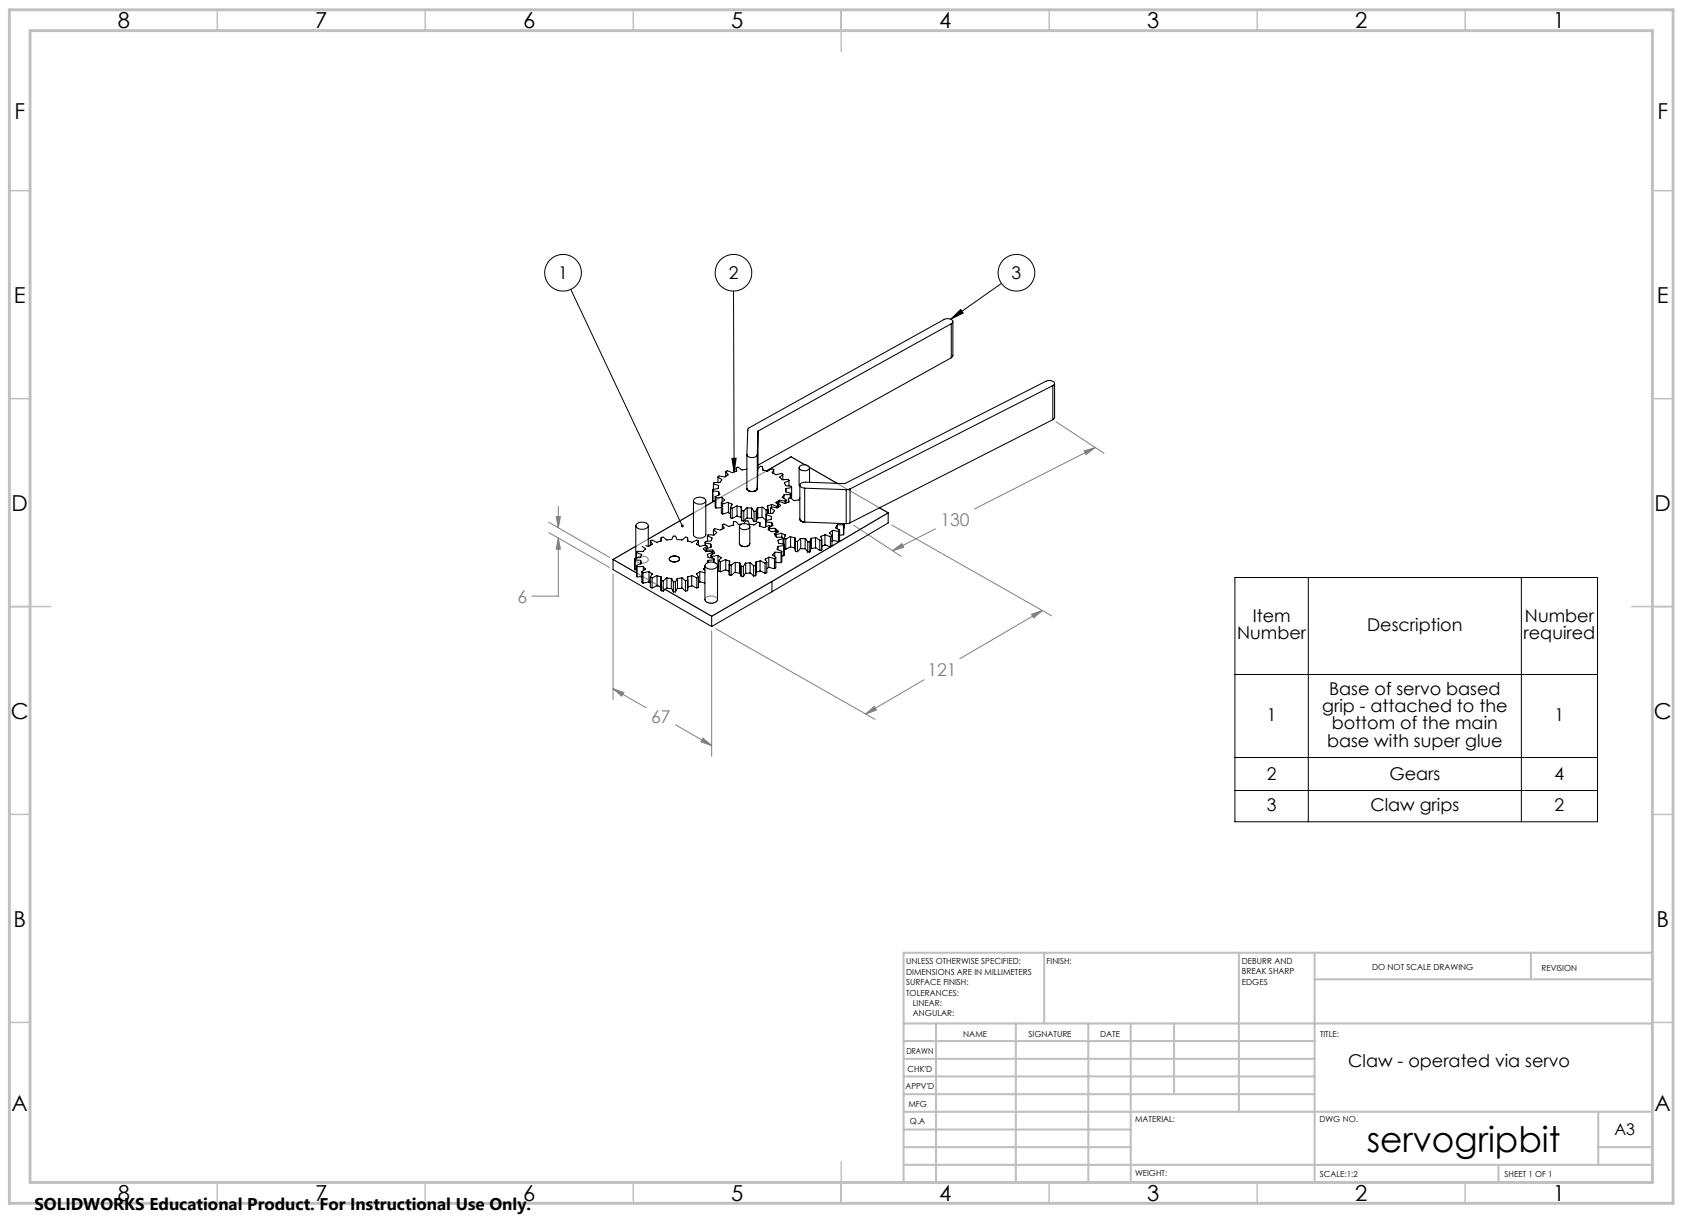
[picture p16: page 18]
FINISH:; DEBURR AND; BREAK SHARP EDGES; DO NOT SCALE DRAWING; REVISION

Number Item | Description | Number required

1 | Base of servo based grip - attached to the bottom of the main base with super glue | 1

2 | Gears | 4
3 | Claw grips | 2

UNLESS OTHERWISE SPECIFIED:
DIMENSIONS ARE IN MILLIMETERS
SURFACE FINISH:
TOLERANCES:
LINEAR:
ANGULAR:

NAME | SIGNATURE | DATE | | | TITLE: Claw - operated via servo

DRAWN
CHK'D
APPV'D
MFG

servogripbit

SCALE:1:2 | SHEET 1 OF 1

6
E | E

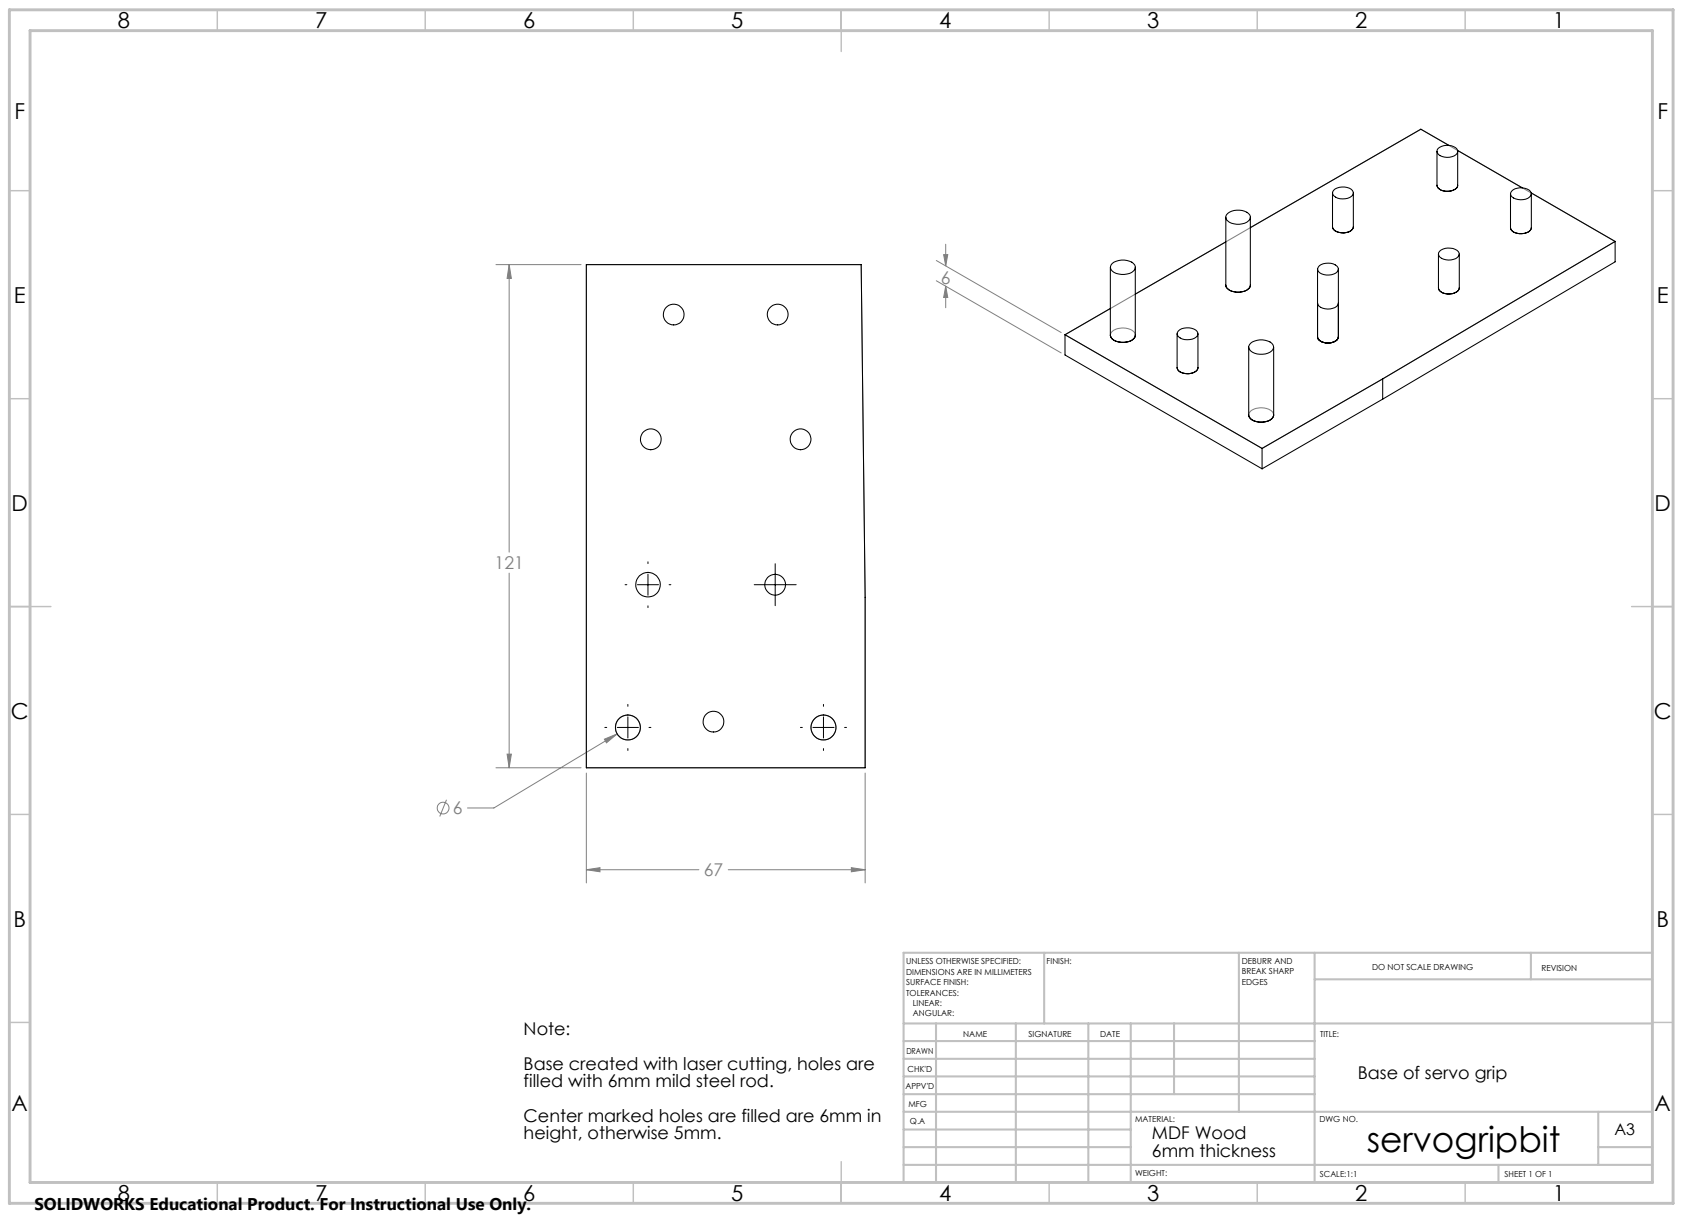
[picture p17: page 19]
height, otherwise 5mm.; MDF Wood; FINISH:; DEBURR AND; BREAK SHARP EDGES; DO NOT SCALE DRAWING; REVISION

UNLESS OTHERWISE SPECIFIED:
DIMENSIONS ARE IN MILLIMETERS
SURFACE FINISH:
TOLERANCES:
LINEAR:
ANGULAR:

Note:
Base created with laser cutting, holes are
filled with 6mm mild steel rod.
Center marked holes are filled are 6mm in

NAME | SIGNATURE | DATE | | | | TITLE: Base of servo grip

DRAWN
CHK'D
APPV'D
MFG

6mm thickness | servogripbit

SCALE:1:1 | SHEET 1 OF 1

R3

E | E

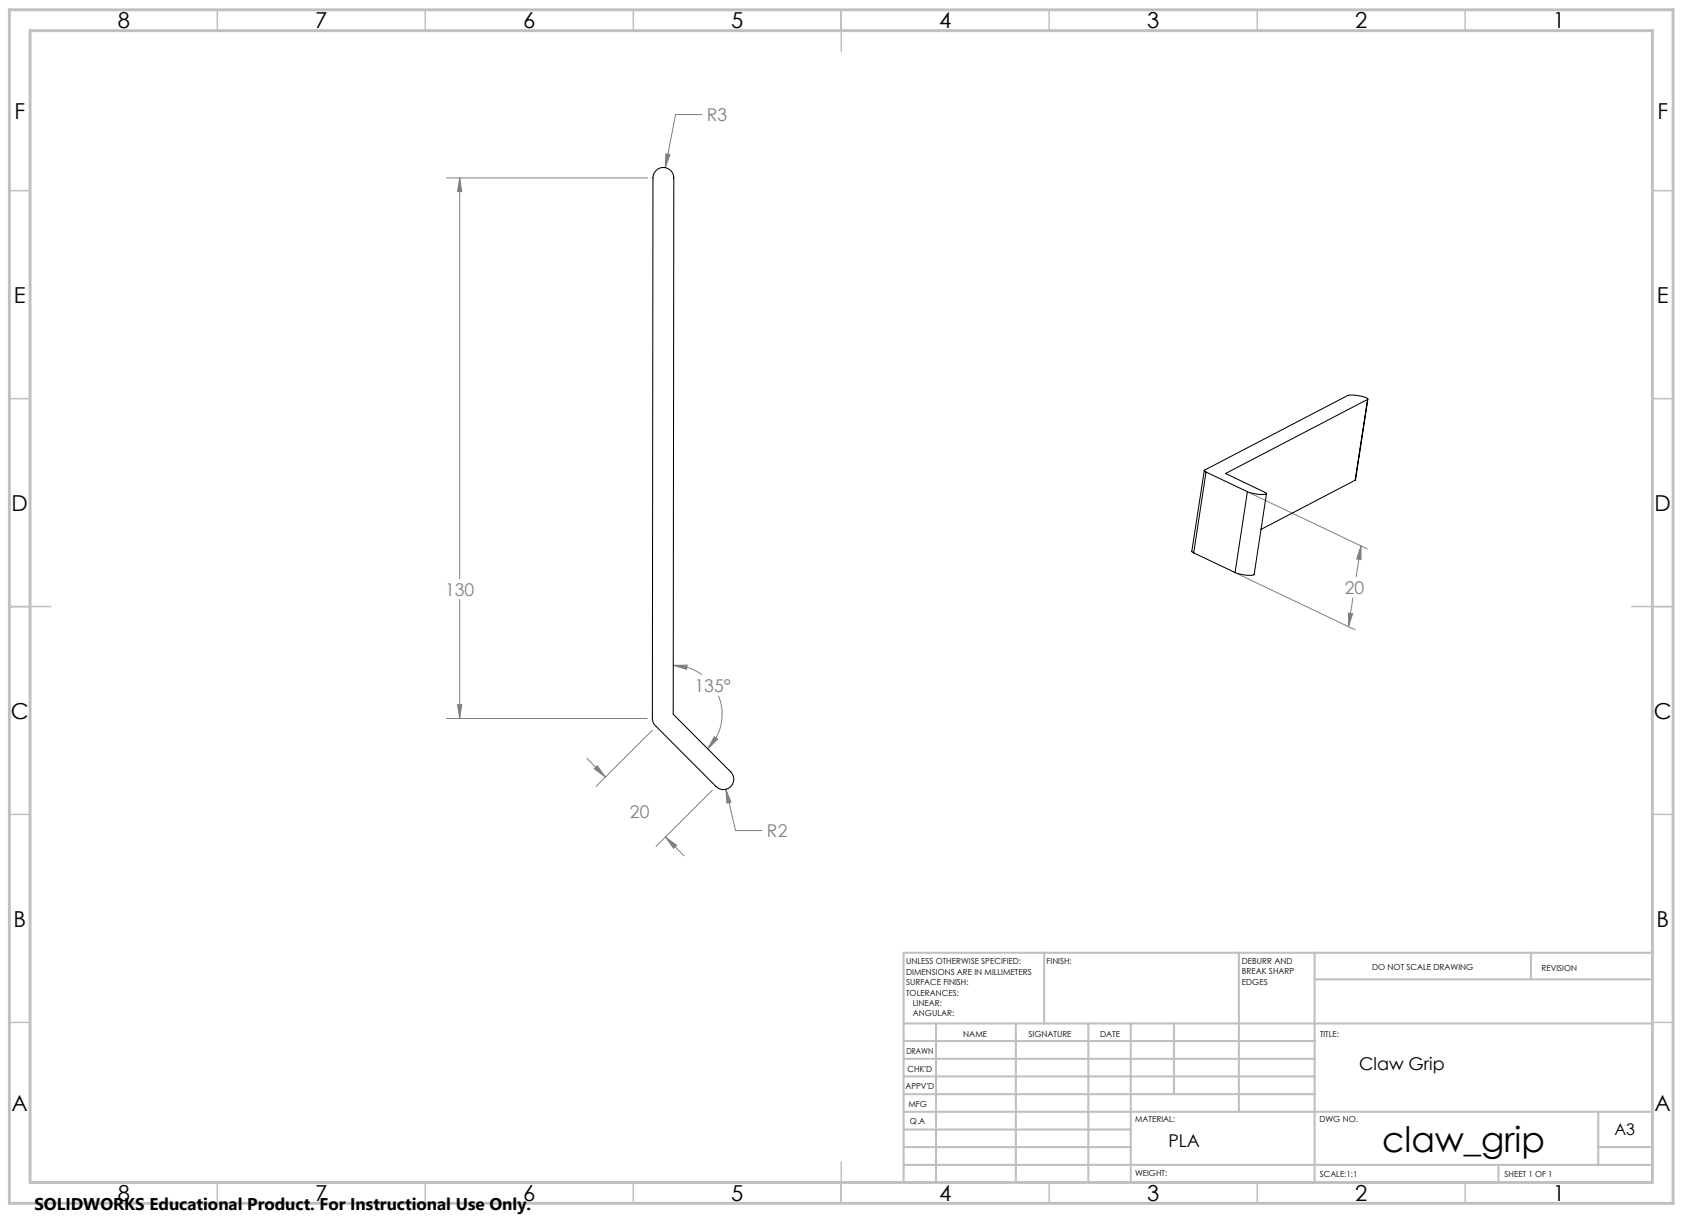
[picture p18: page 20]
FINISH:; DEBURR AND; BREAK SHARP EDGES; DO NOT SCALE DRAWING; REVISION

UNLESS OTHERWISE SPECIFIED:
DIMENSIONS ARE IN MILLIMETERS
SURFACE FINISH:
TOLERANCES:
LINEAR:
ANGULAR:

NAME | SIGNATURE | DATE | | | | TITLE: Claw Grip

DRAWN
CHK'D
APPV'D
MFG

PLA | claw_grip

SCALE:1:1 | SHEET 1 OF 1

1

6

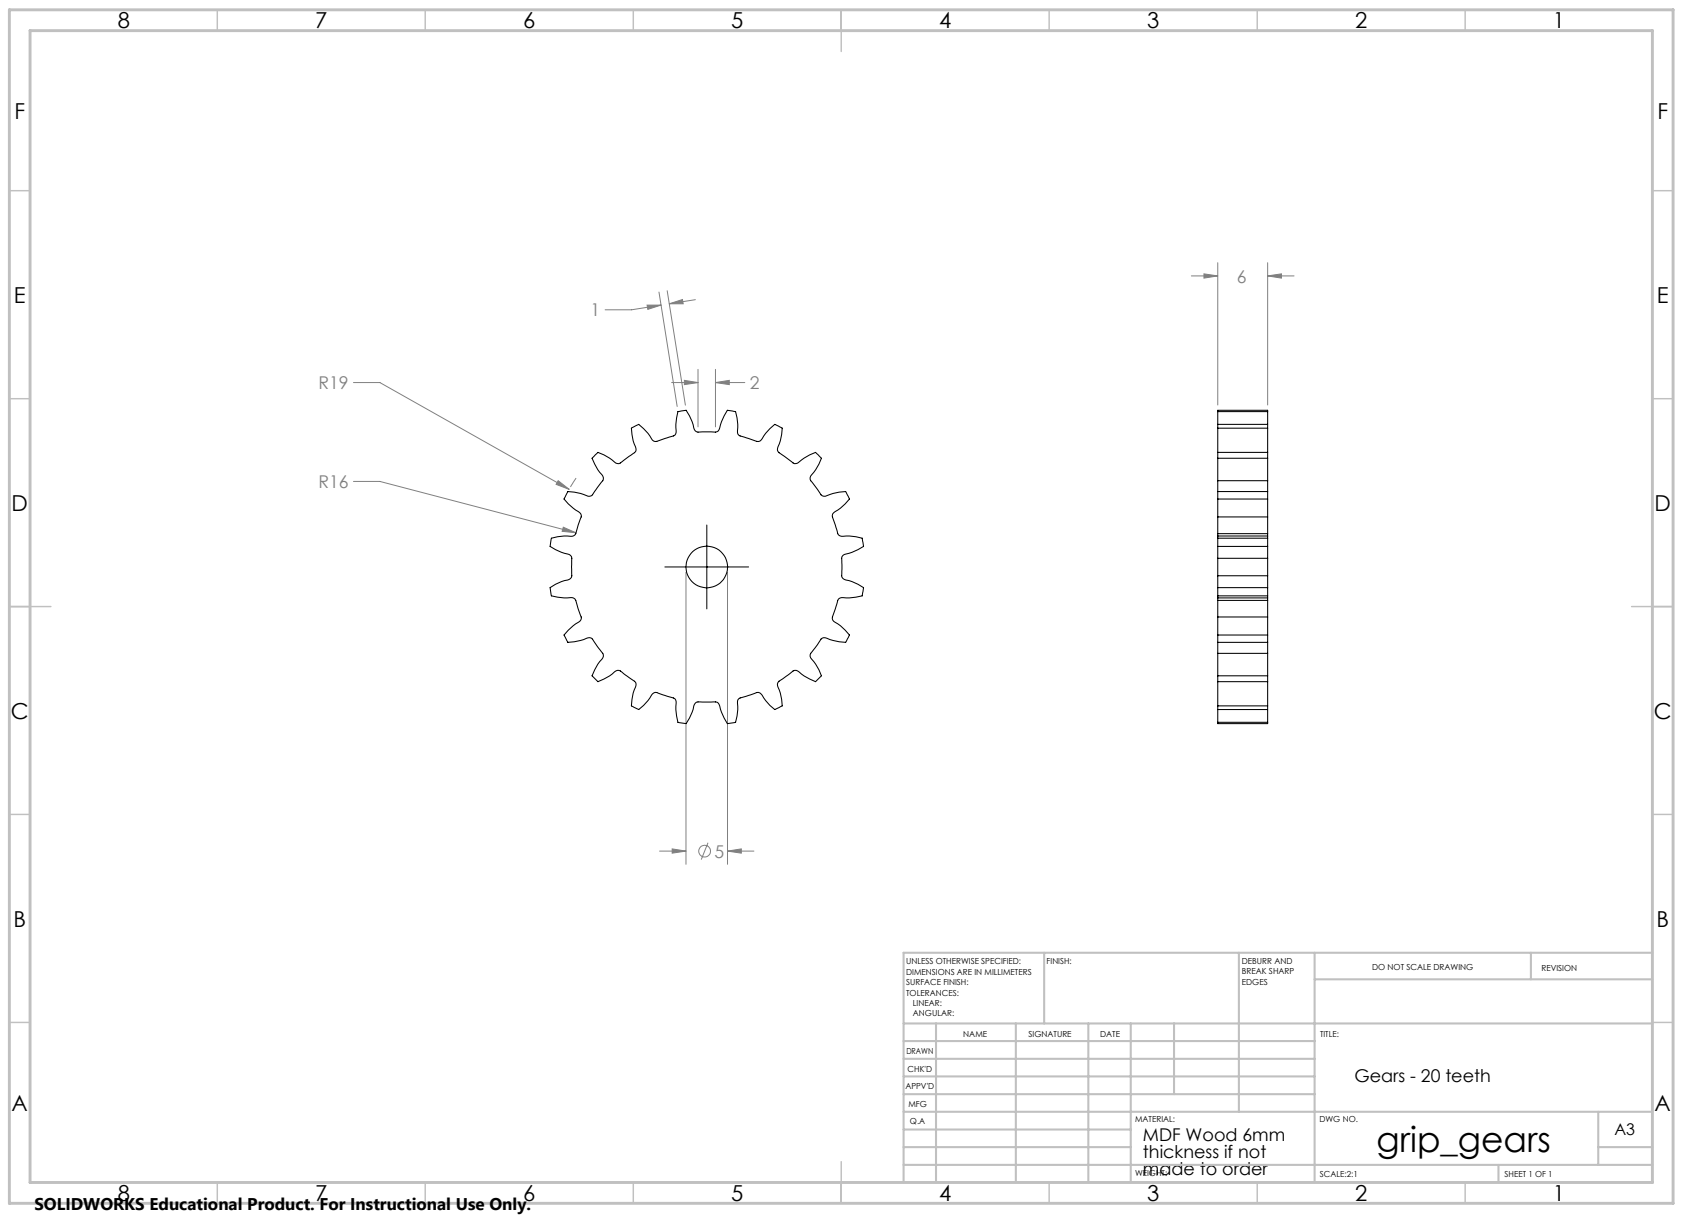
[picture p19: page 21]
FINISH:; DEBURR AND; BREAK SHARP EDGES; DO NOT SCALE DRAWING; REVISION

UNLESS OTHERWISE SPECIFIED:
DIMENSIONS ARE IN MILLIMETERS
SURFACE FINISH:
TOLERANCES:
LINEAR:
ANGULAR:

NAME | SIGNATURE | DATE | | | | TITLE: Gears - 20 teeth

DRAWN
CHK'D
APPV'D
MFG

MDF Wood 6mm thickness if not made to order | grip_gears

SCALE:2:1 | SHEET 1 OF 1

8

E | E

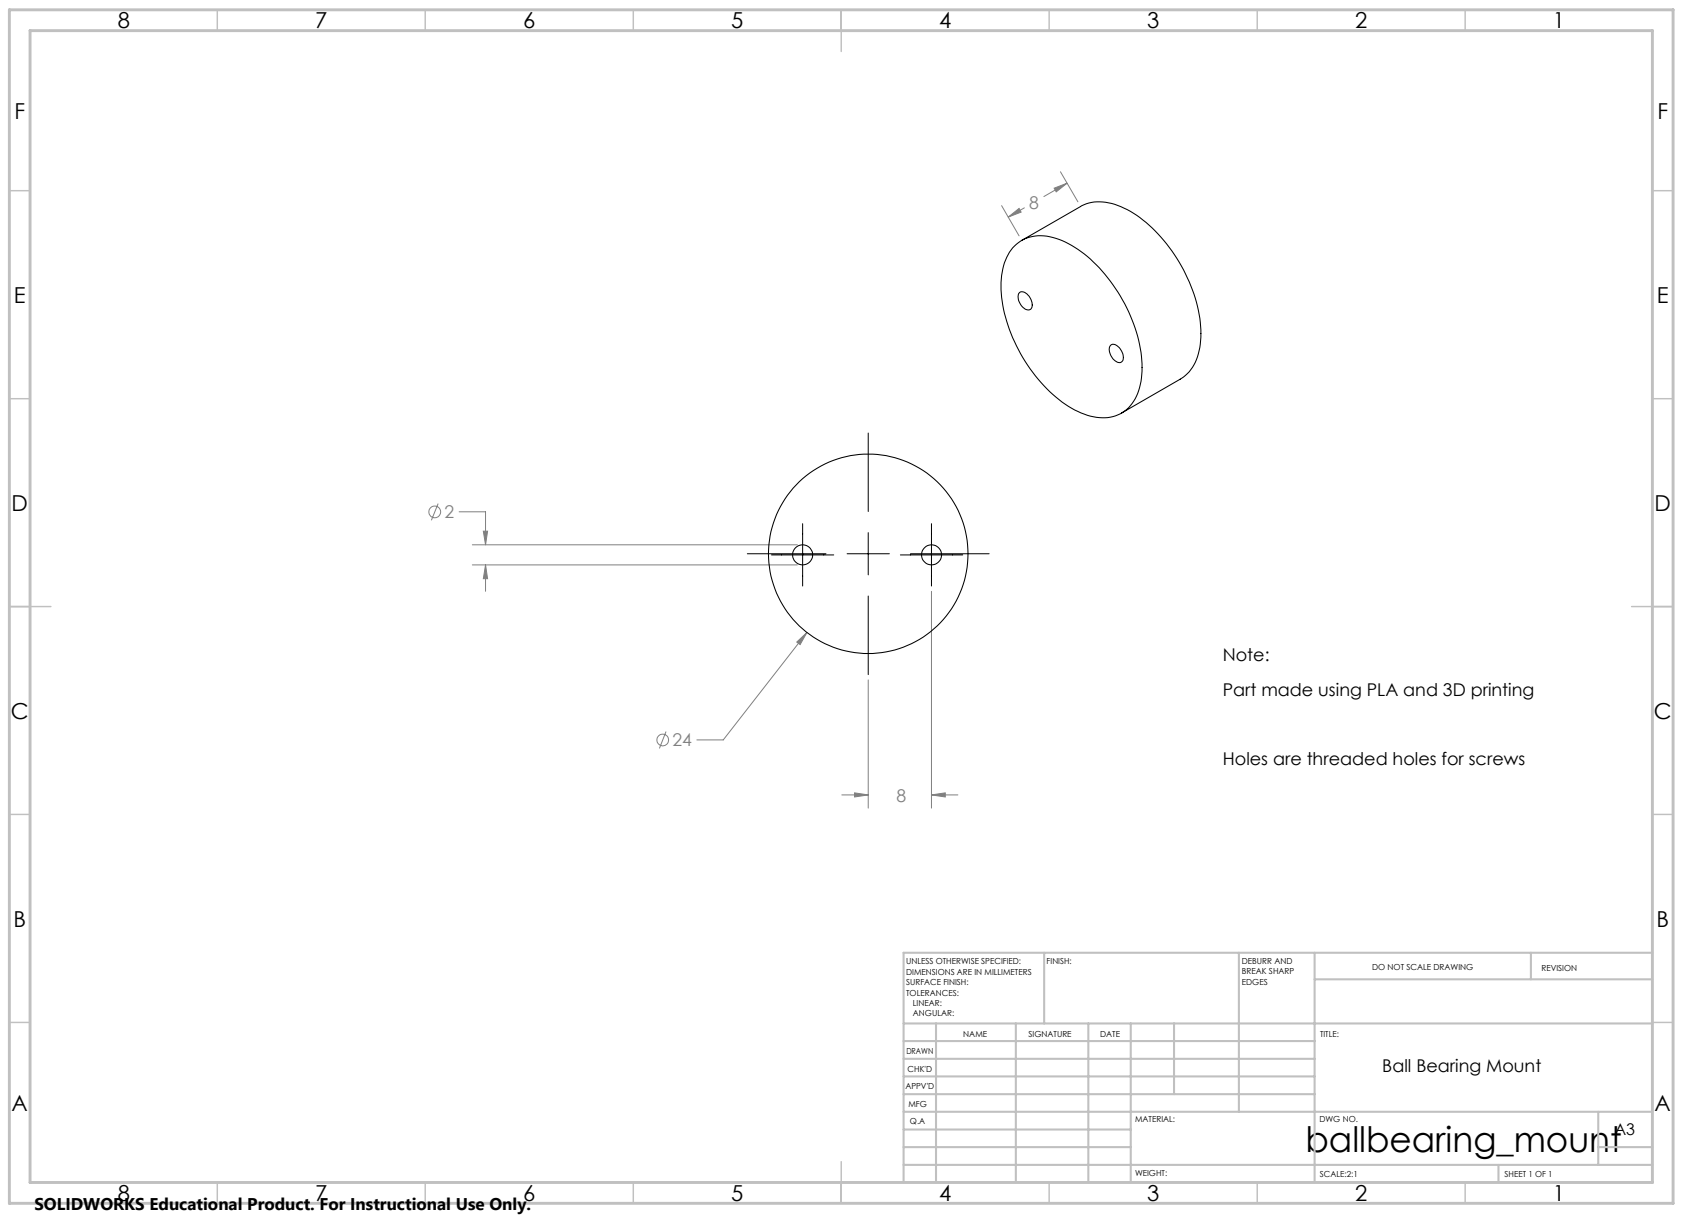
[picture p20: page 22]
FINISH:; DEBURR AND; BREAK SHARP EDGES; DO NOT SCALE DRAWING; REVISION

Note:
Part made using PLA and 3D printing

Holes are threaded holes for screws

UNLESS OTHERWISE SPECIFIED:
DIMENSIONS ARE IN MILLIMETERS
SURFACE FINISH:
TOLERANCES:
LINEAR:
ANGULAR:

NAME | SIGNATURE | DATE | | | | TITLE: Ball Bearing Mount

DRAWN
CHK'D
APPV'D
MFG

ballbearing_mount

SCALE:2:1 | SHEET 1 OF 1

R10.0

R2.4

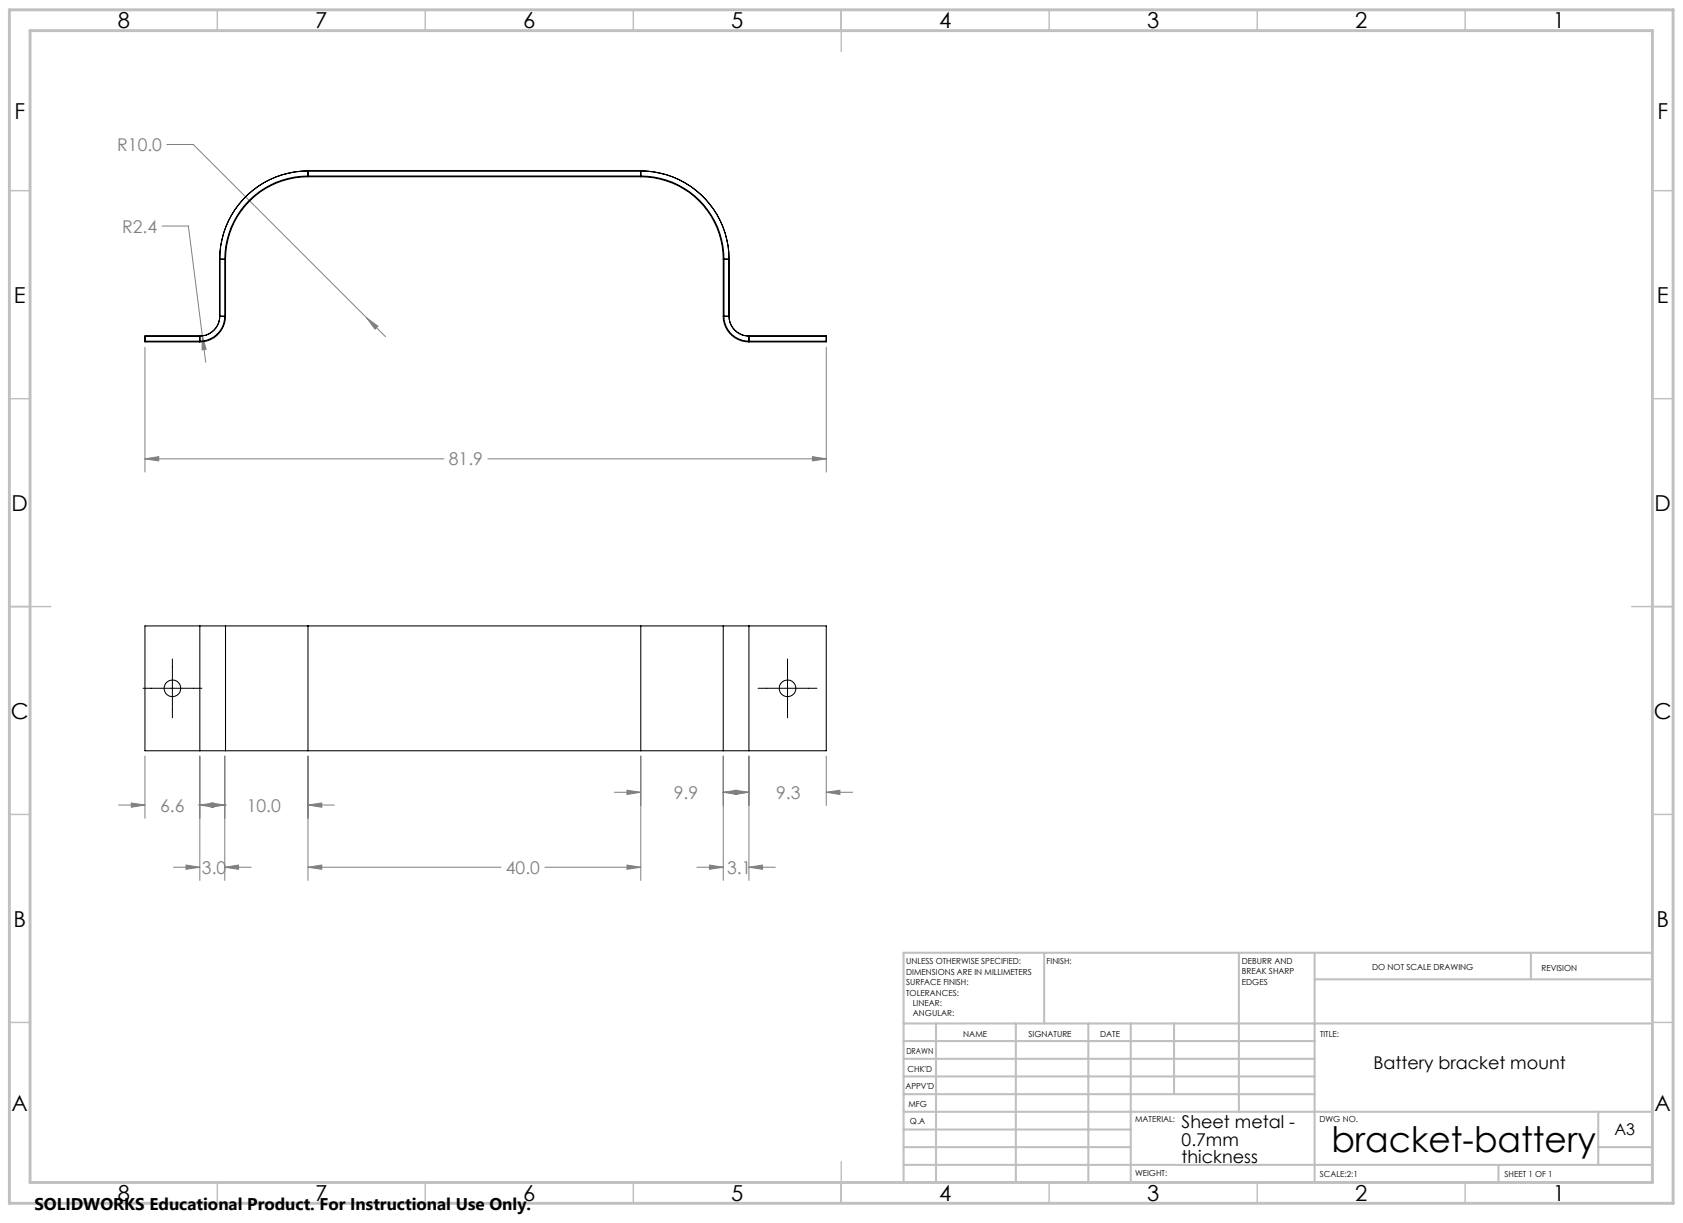
[picture p21: page 23]
FINISH:; DEBURR AND; BREAK SHARP EDGES; DO NOT SCALE DRAWING; REVISION

UNLESS OTHERWISE SPECIFIED:
DIMENSIONS ARE IN MILLIMETERS
SURFACE FINISH:
TOLERANCES:
LINEAR:
ANGULAR:

NAME | SIGNATURE | DATE | | | | TITLE: Battery bracket mount

DRAWN
CHK'D
APPV'D
MFG

Sheet metal -0.7mm thickness | bracket-battery

SCALE:2:1 | SHEET 1 OF 1

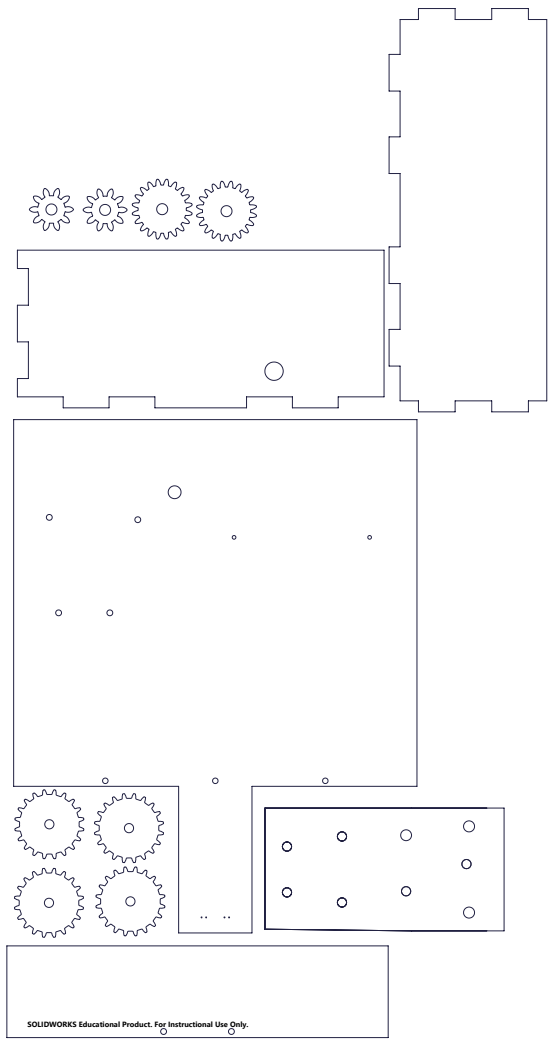
[picture p22: page 24]

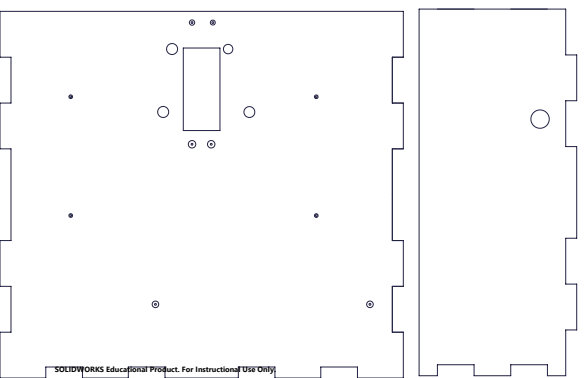
[picture p23: page 25]

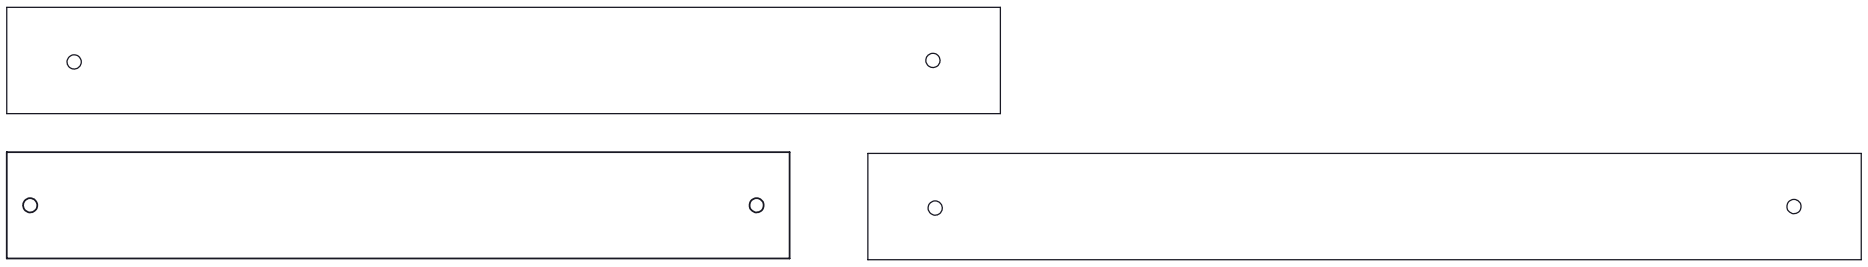
[picture p24: figure]
