antroseco/idp/EAGLE/IDP5.pdf

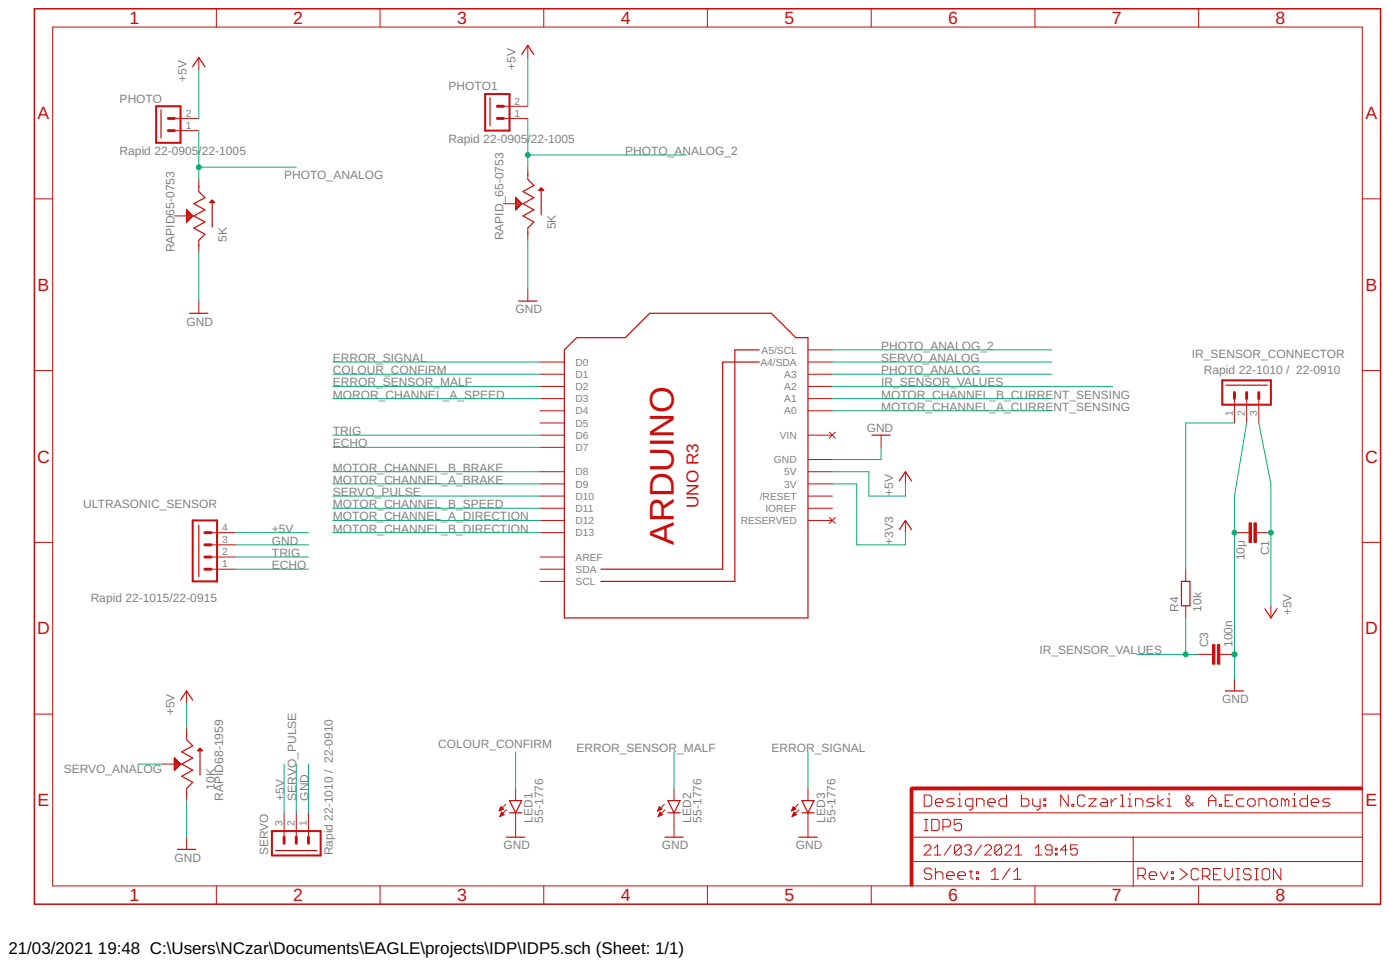
[picture p25: page 1]

21/03/2021 19:48 C:\Users\NCzar\Documents\EAGLE\projects\IDP\IDP5.sch (Sheet: 1/1)
