antroseco/idp/EAGLE/IDP5_layout.pdf

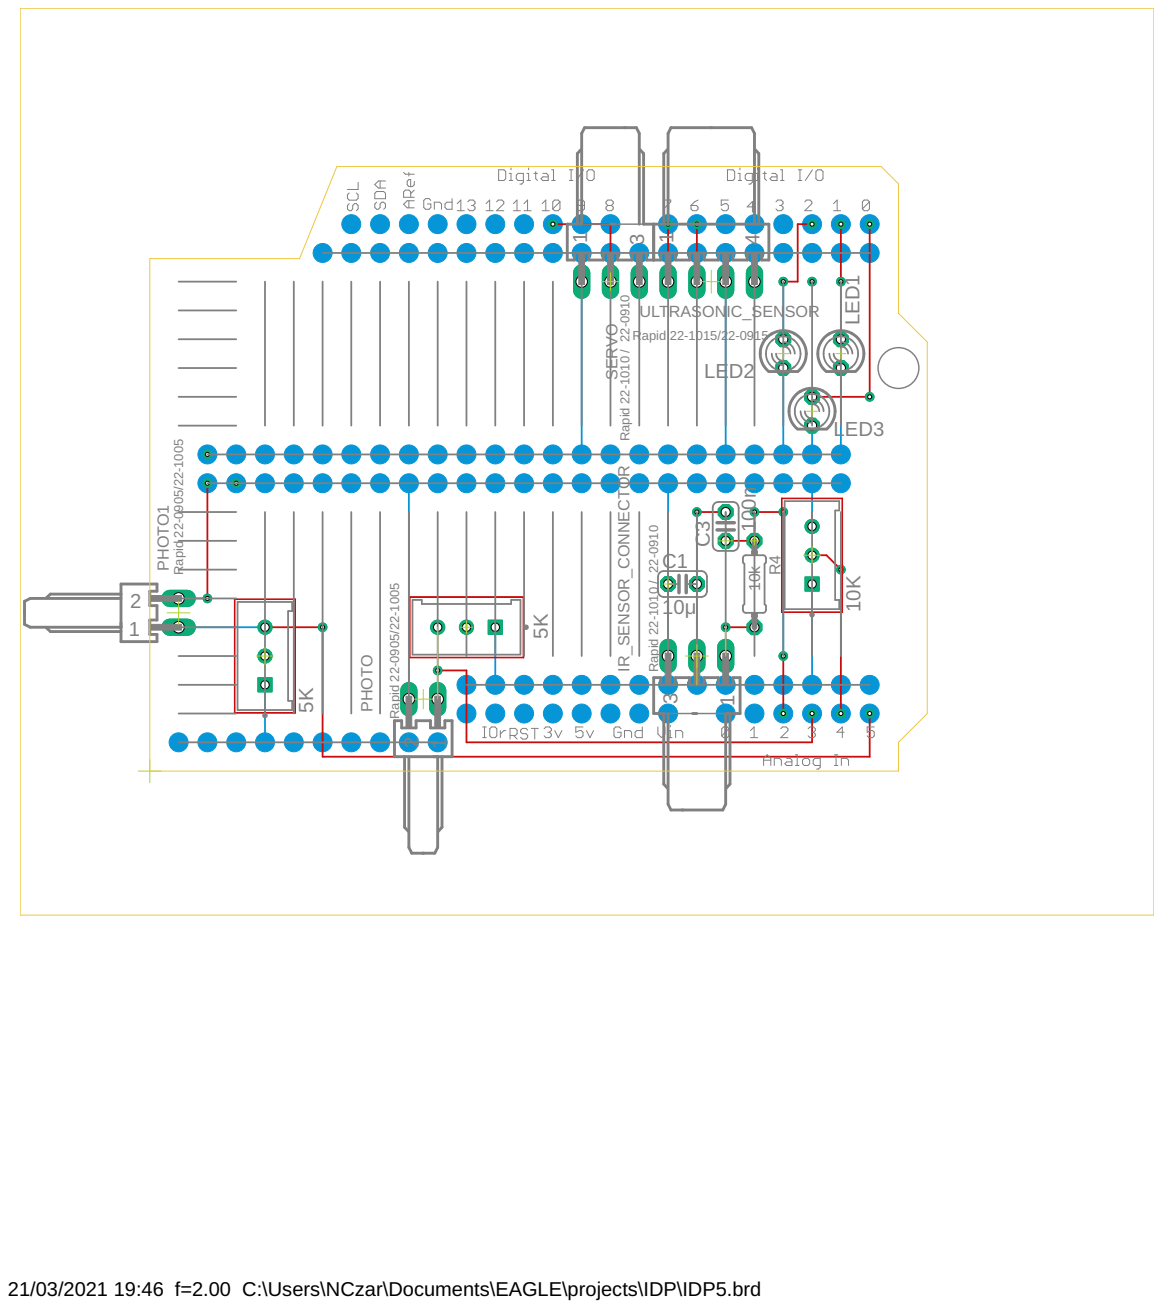
[picture p26: page 1]

21/03/2021 19:46 f=2.00 C:\Users\NCzar\Documents\EAGLE\projects\IDP\IDP5.brd
