antroseco/idp/LTspice/LightDetector (OpAmp, EMA).asc

C1: cap; 100µ
I1: current; PULSE(78u 85u 4 1 2 0 30)
R1: res; 24k
R3: res; 10k
R5: res; 10
R6: res; 100k
U1: LM741_NS
U2: LM741_NS
U3: LM339
U4: LM741_NS
V1: voltage; 5
V3: voltage; 5
Named nets: 0, phototransistor, out, signal, ema, Vcc
.tran 0 60 0 0.1
