antroseco/idp/LTspice/LightDetector (Comparator).asc

Cgpio: cap; 14p
I1: current; PULSE(20u 200u 0 4 1 0 5)
Rgpio: res; 1Meg
Rload: res; 24k
Rp1: res; 500k
Rp2: res; 80k
Rpullup: res; 10k
U1: LM339
V1: voltage; 5
V2: voltage; 5
Named nets: 0, phototransistor, out, ref
.tran 0 10 0 0.01
