antroseco/idp/LTspice/LightDetector.asc

C2: cap; 14p
I1: current; PULSE(20u 200u 0 4 1 0 5)
R1: res; 24k
R4: res; 1Meg
V1: voltage; 5
Named nets: 0, phototransistor, out
.tran 0 10 0 0.01
