antroseco/idp/LTspice/LightDetector (OpAmp).asc

C1: cap; 10m
C2: cap; 14p
C3: cap; 14p
I1: current; PULSE(100u 230u 0 4 1 0 5)
R1: res; 10k
R2: res; 1
R3: res; 1Meg
R4: res; 1Meg
U1: opamp
V1: voltage; 5
Named nets: 0, phototransistor, out_ema, out
.tran 0 10 0 0.01
.lib opamp.sub
