antroseco/idp/(commit log)

2021-02-28 Add files via upload
    Robot in world with wheels, claws, ball bearing and sensors modelled, sensors parameters not set yet
2021-02-28 Ultrasonic Sensor and Proto
    Finished and can be added to the main robot.
2021-02-28 EAGLE files
    [IDP.brd, IDP.sch]
2021-02-28 Added sensors, initial robot controller
    Added emitter, receiver, gps and compass to the robot
    Made an initial controller for our robot, just added all of the functions we already wrote
2021-02-28 Updated Ultrasonic sensor.
2021-02-28 Added Ultrasonic Sensor
2021-02-28 Add controller for ultrasonic sensor
2021-03-01 fixed wheel orientation and controller bugs
2021-03-01 More LTspice schematics
    Looks like we can't use OpAmps, so just connect it directly to the ADC
    and do all processing in software
2021-03-01 Get IR distance sensor values and changed placement of ultrasonic sensor
    The 'beams' of the IR and ultrasonic are now parallel. IR sensor values are also accessible.
2021-03-01 Update Sensors Lookup Table
2021-03-01 hardware.py: Implement ADC input
2021-03-01 Convert Voltages to Meters on IR Sensor
2021-03-01 hardware.py: Simulate phototransistor circuit
2021-03-01 Robot_controller.py: read Light sensor
2021-03-01 TEPT4400.proto: make sure geomeotry doesn't occlude the sensor
2021-03-01 changed name of IR sensor
2021-03-01 Added IR sensor
    [IDP.brd, IDP.sch]
2021-03-01 Changed bot size to width 20 cm
2021-03-01 Made the Box Claw for the robot, adjusted a few joints
2021-03-01 Added code to control Box Claw
2021-03-02 Finished the Electronics Circuit Diagrams and Layout
    [IDP2.brd, IDP2.sch]
2021-03-02 Finishing touches on Frame
    [IDP2.sch]
2021-03-02 Include Servo and Change Phototransistor Layout
    [IDP2.brd, IDP2.sch]
2021-03-02 Added Part Names
    [IDP2.brd, IDP2.sch]
2021-03-02 Transform Analog Phototransistor to Digital and Add LED for Testing
    [IDP3.brd, IDP3.sch]
2021-03-03 Add noise to ultrasonic signal
    PID control still works. Noise modelled as standard deviation of 0.002m. No need to remove the noise from ultrasonic signal.
2021-03-04 Enlarged box claw
2021-03-05 TEPT4000 with red and green filter proto
    Signed-off-by Jerry
2021-03-05 Added BOX_CLAW.proto, use this as endpoint in case we want to use this claw again
2021-03-05 Dual—Claw Mechanism Implemented
2021-03-05 upload controller code for controlling claw
2021-03-06 added a function that tells us where to put the box
    will change this one so that it takes into account the current robot position
2021-03-06 Add colour filter options to the TEPT4400 PROTO
2021-03-06 Update colour filter transmissivity from datasheets
2021-03-06 Warn when both colour filters are applied
2021-03-06 Right sensor names and protos used
2021-03-06 Adjust IR sensor to model voltages before the voltage peak
2021-03-07 Updated max torque and speeds.
2021-03-08 Completed Analog Circuit and Back Layout
    Just LEDs are needed to be added.
    [IDP4.brd, IDP4.sch]
2021-03-08 Added LED :+1:
    [IDP4.brd, IDP4.sch]
2021-03-08 Added low pass filter
    [IDP4.brd, IDP4.sch]
2021-03-08 Simple Design
    [IDP5.brd, IDP5.sch]
2021-03-08 Update speeds after decreasing req torque.
2021-03-08 64 rpm due to gears
2021-03-09 Agreed dimensions with CAD
2021-03-09 changed velocities for turning
2021-03-09 documentation and setting max velocity
2021-03-09 Ready for submission
    [IDP5.brd, IDP5.sch]
2021-03-10 adjusted ultrasonic sensor position
2021-03-10 Tuned PID and optimised rotation
2021-03-10 Remove dead code (box claw actuation)
2021-03-10 moved bearing functions to robot class, updated collisions
2021-03-10 Don't print measurement result
2021-03-12 Trace function calls
2021-03-12 Make bearing and bearing1 static methods
2021-03-12 Improve bearing functions
    This should be able to handle all edge cases, also code re-use
2021-03-12 Use correct bearing version
2021-03-13 improved collisions
    can be further improved:
    (1) store other robots' bearing as well as position, and move until the way is cleared for the other robot
    (2) if it's possible to turn both left and right, take into account where is the robot currently headed
    (3) also when avoidance happens we need to somehow trigger that in pid_translate function so that it readjusts the angle
2021-03-13 send bearing along with location
2021-03-13 3 timesteps PID
2021-03-13 Partially revert "3 timesteps PID"
    This partially reverts commit c85c3f694f7575ba9419ad5c6fef1b0c396a7c51.
    Restore console windows
2021-03-13 Add motor helper methods
2021-03-13 Accounts for wall and sensor
    Accounts for wall thickness. This allows the boxes in the corners to be found. Also, sensor is actually placed 0.09m from centre of the robot, not 0.11m.
2021-03-13 Single function for claw mechanism, get_target() remeasure now checks according to distance moved instead of steps moved
2021-03-14 PID values for translation
2021-03-14 Properly set sensor sampling periods
2021-03-14 Tighten move_forwards default threshold
2021-03-14 trimmed claw codes
2021-03-14 change colour sensor angle
2021-03-16 Merge - sensor measurements every timestep, updating previous box locations. (#2)
    * Time step measurements 1
    * 2
    * 3
    * very ugly
    * Hmmmm
    * Sending updated box locations and new message type
2021-03-16 Don't print when rerouting
2021-03-17 added update_unique_boxes and updated sensor readings at each time step (non working)
2021-03-17 Remove prints.
2021-03-17 box collisions switch
2021-03-21 Final Version
    [IDP5.brd, IDP5.sch]
2021-03-21 few changes
    [IDP5.brd, IDP5.sch]
